EdgarMata/MY-Laser-CNC/278374579_10227413343910427_8267274377528883599_n.jpg

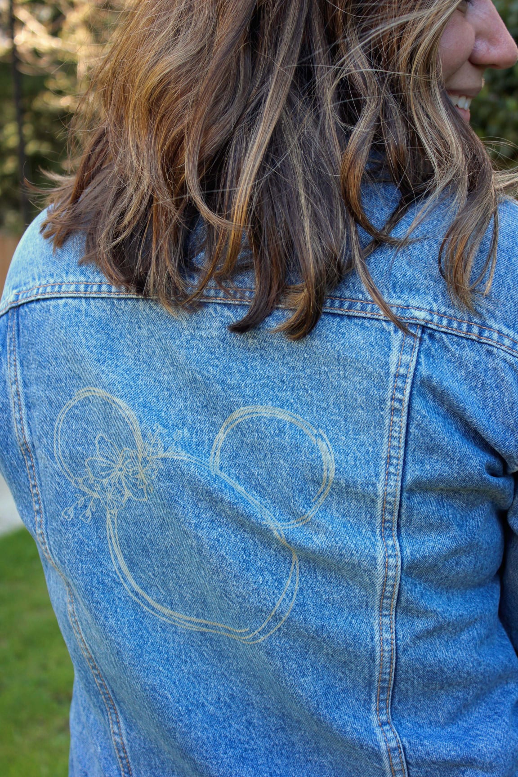
278374579_10227413343910427_8267274377528883599_n.jpg
