EdgarMata/MY-Laser-CNC/278366584_10227413344310437_1615012592259334442_n.jpg

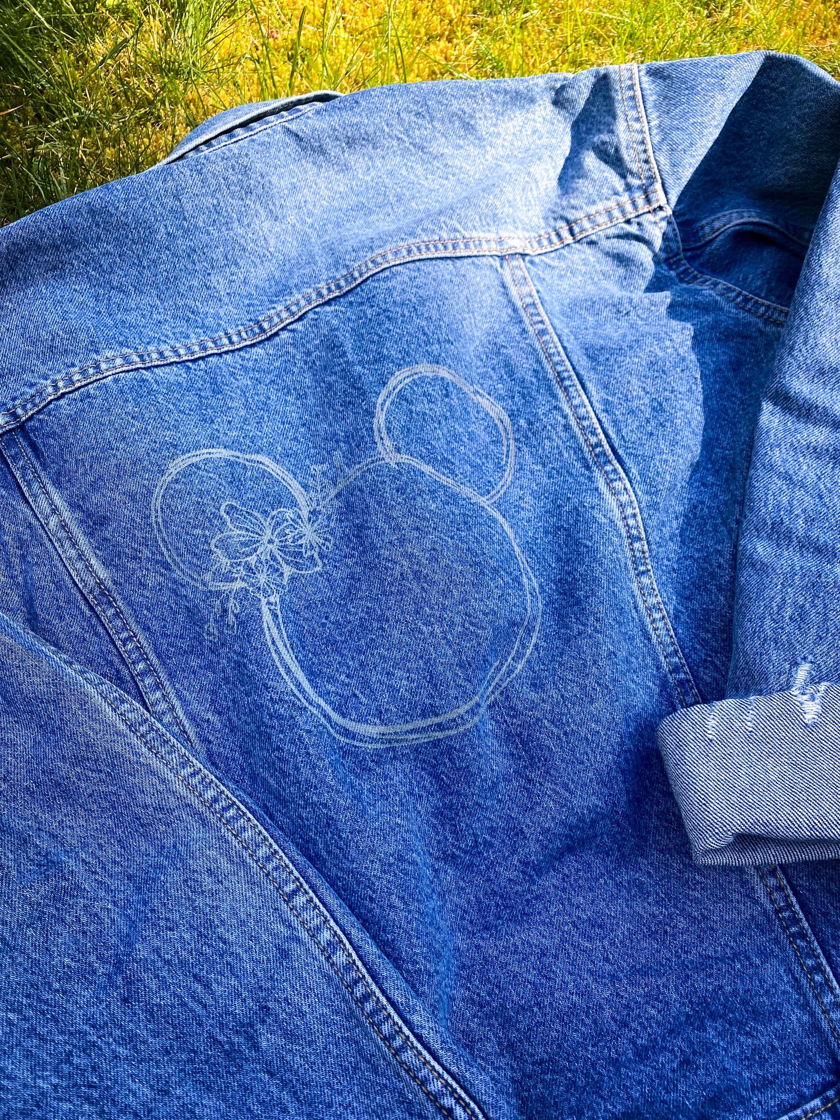
278366584_10227413344310437_1615012592259334442_n.jpg
