EdgarMata/MY-Laser-CNC/Ai Assist 12V - Ortur LaserMaster 2/README.txt

Ortur Lasermaster 2, Air-Assist 12V by PLAY3Rone977 on Thingiverse: https://www.thingiverse.com/thing:4603611
