EdgarMata/MY-Laser-CNC/Dragchain mounts - Ortur LaserMaster 2/README.txt

Ortur laser master 2 dragchain mounts by Jaytjuh575 on Thingiverse: https://www.thingiverse.com/thing:4782844
