EdgarMata/MY-Laser-CNC/Height Adjustment - Ortur LaserMaster 2/README.txt

Height Adjustment Ortur Laser Master 2, Höhenverstellung Lasermaster 2 by PLAY3Rone977 on Thingiverse: https://www.thingiverse.com/thing:4607685
