EdgarMata/MY-Laser-CNC/86872527-235a1d80-c10f-11ea-974b-6ad1a2480c95.png

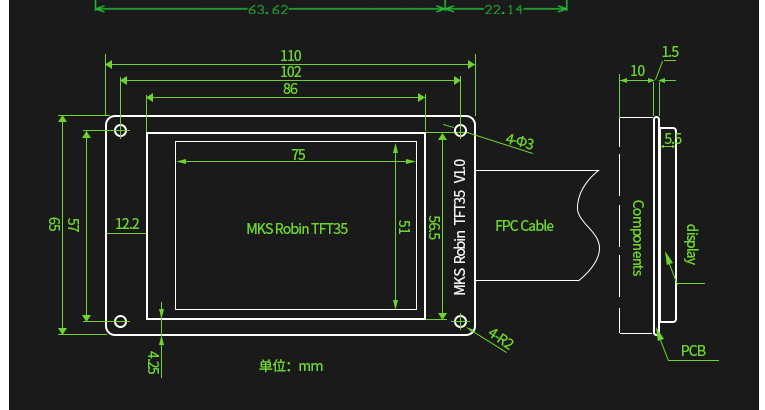
86872527-235a1d80-c10f-11ea-974b-6ad1a2480c95.png
