EdgarMata/MY-Laser-CNC/278289350_10227413347870526_7224577717583131568_n.jpg

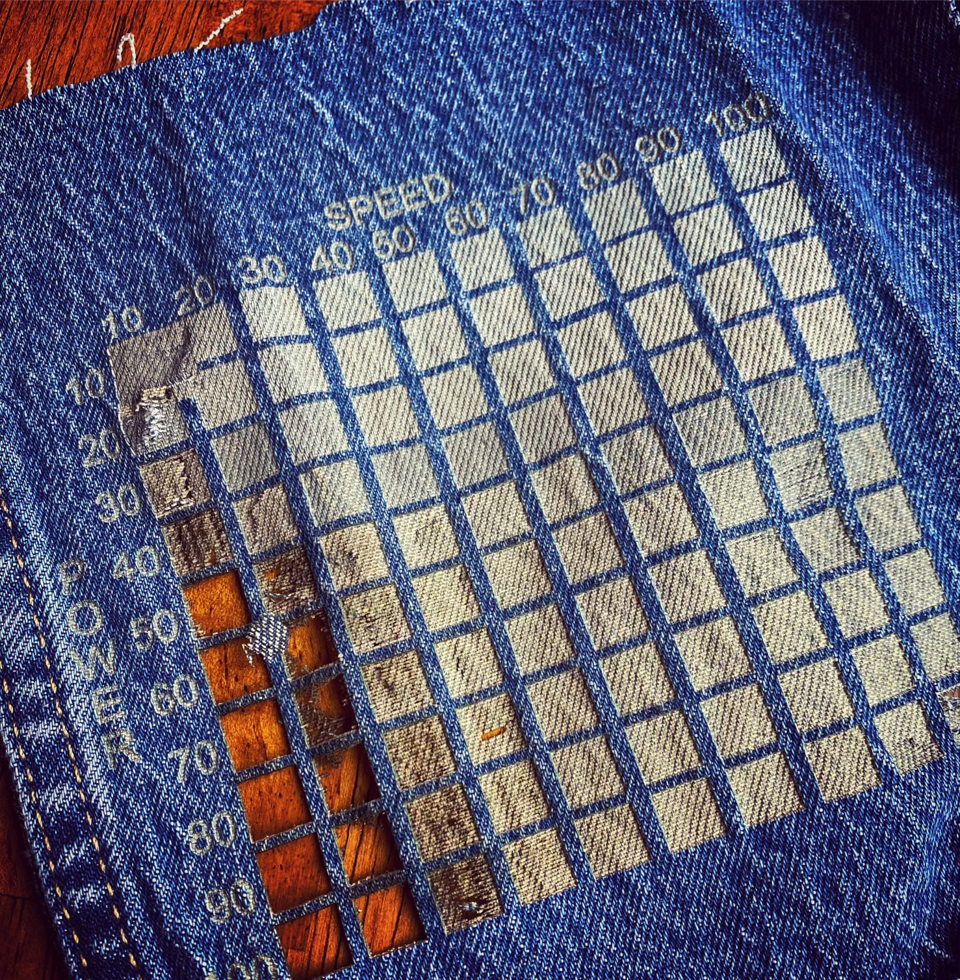
278289350_10227413347870526_7224577717583131568_n.jpg
