EdgarMata/MY-Laser-CNC/1862522707-1764711335.jpg

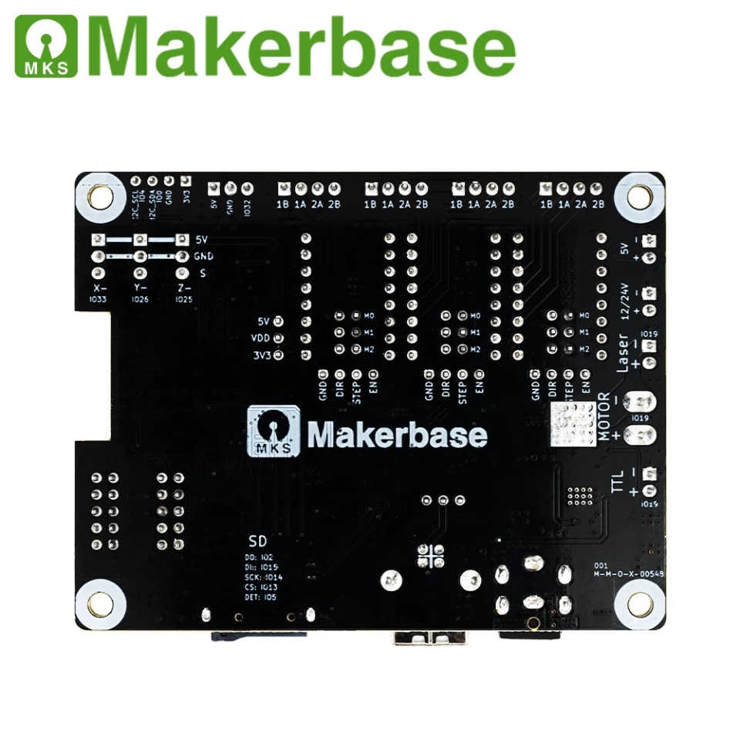
1862522707-1764711335.jpg
