EdgarMata/MY-Laser-CNC/1863638398-807966274.jpg

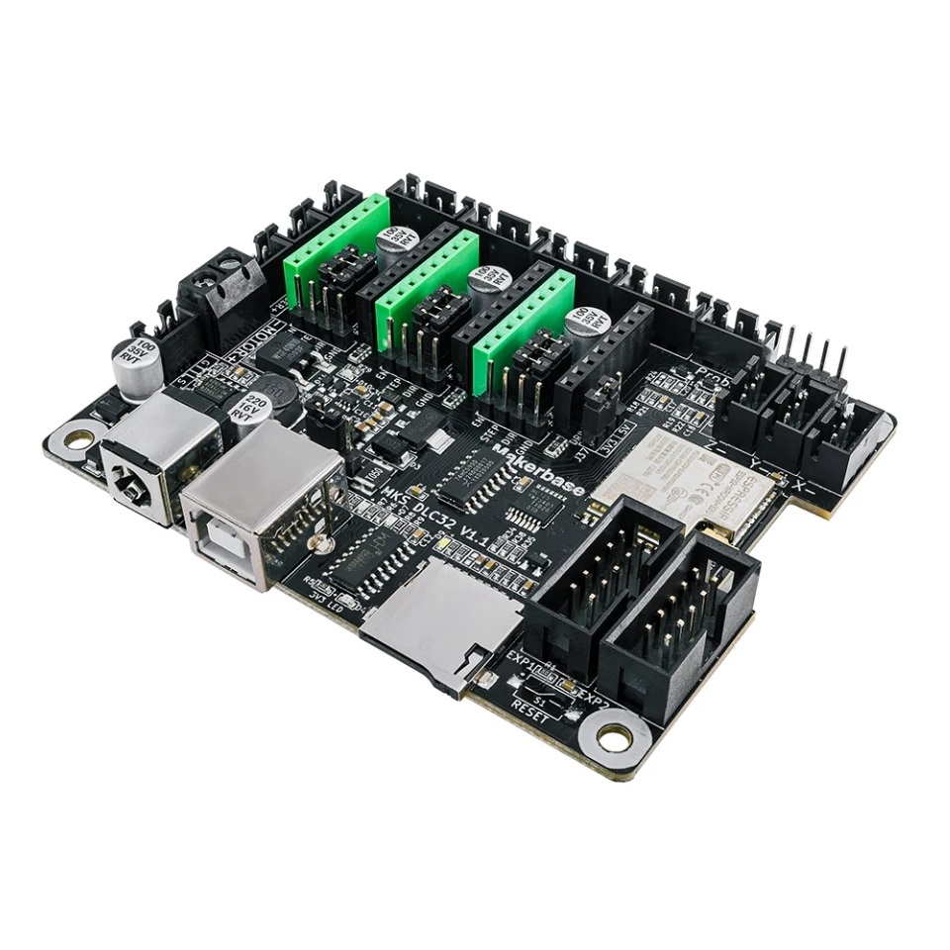
1863638398-807966274.jpg
