EdgarMata/MY-Laser-CNC/10772418951689463713.jpg

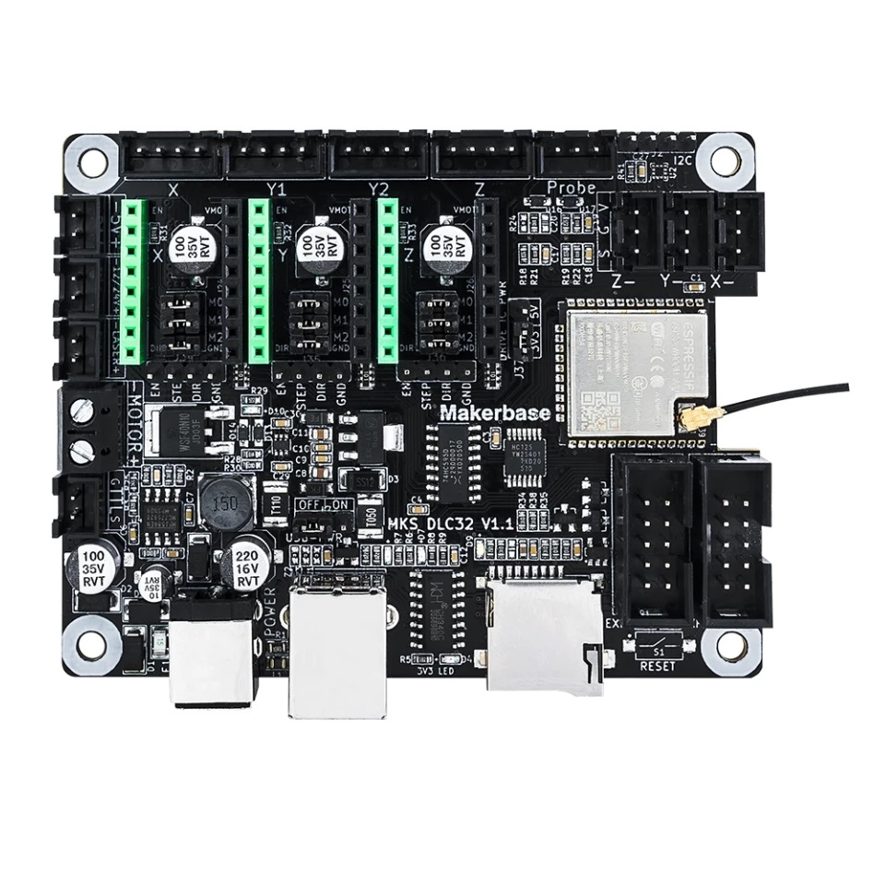
10772418951689463713.jpg
