EdgarMata/MY-Laser-CNC/140004821104248758.jpg

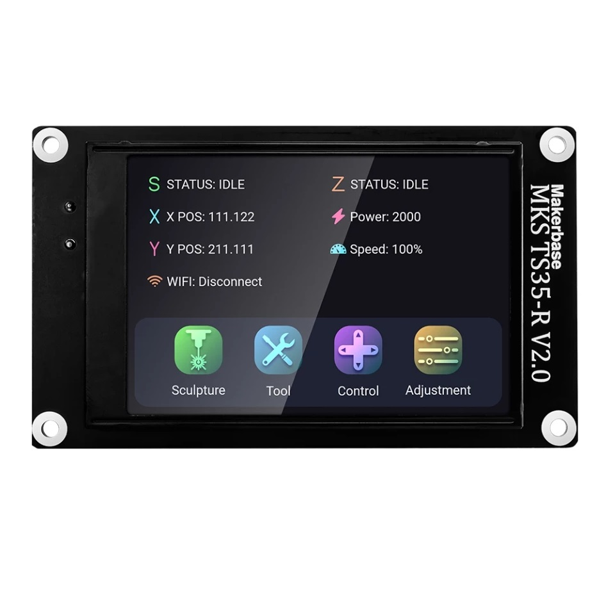
140004821104248758.jpg
