EdgarMata/MY-Laser-CNC/-18785047531269914618.jpg

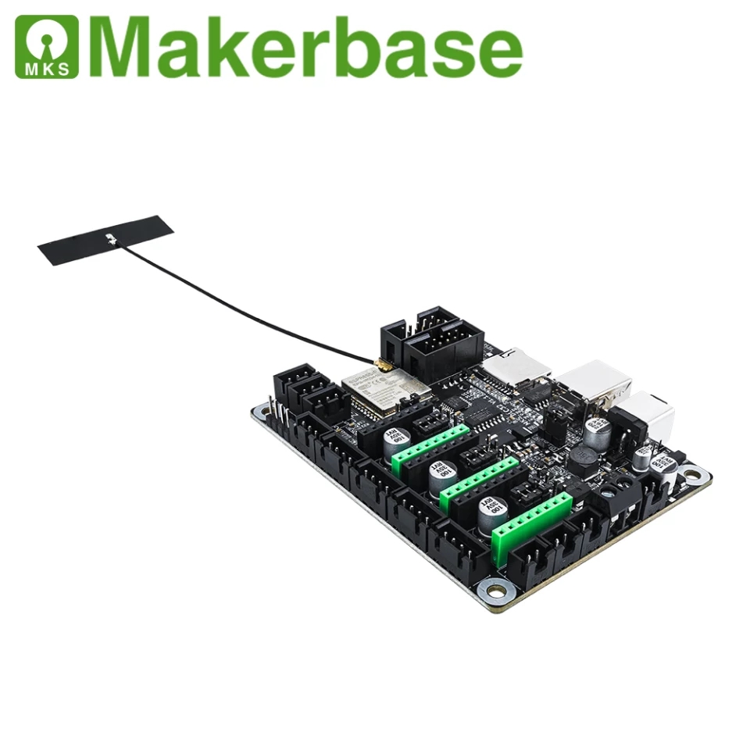
-18785047531269914618.jpg
