EdgarMata/MY-Laser-CNC/Dragchain mounts - Ortur LaserMaster 2/images/LM2_dragchain.jpg

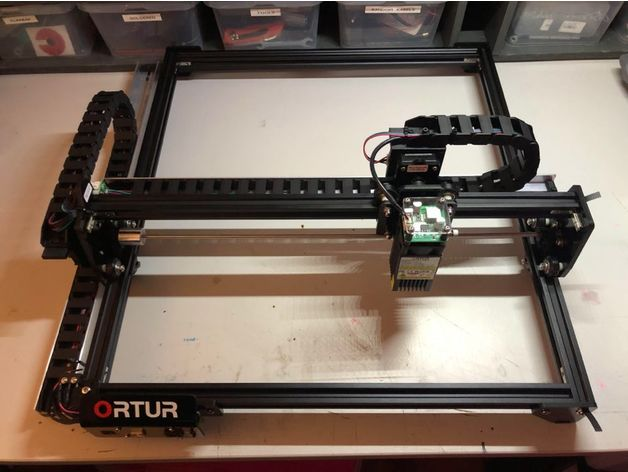
Dragchain mounts - Ortur LaserMaster 2/images/LM2_dragchain.jpg
