EdgarMata/MY-Laser-CNC/Folder.jpg

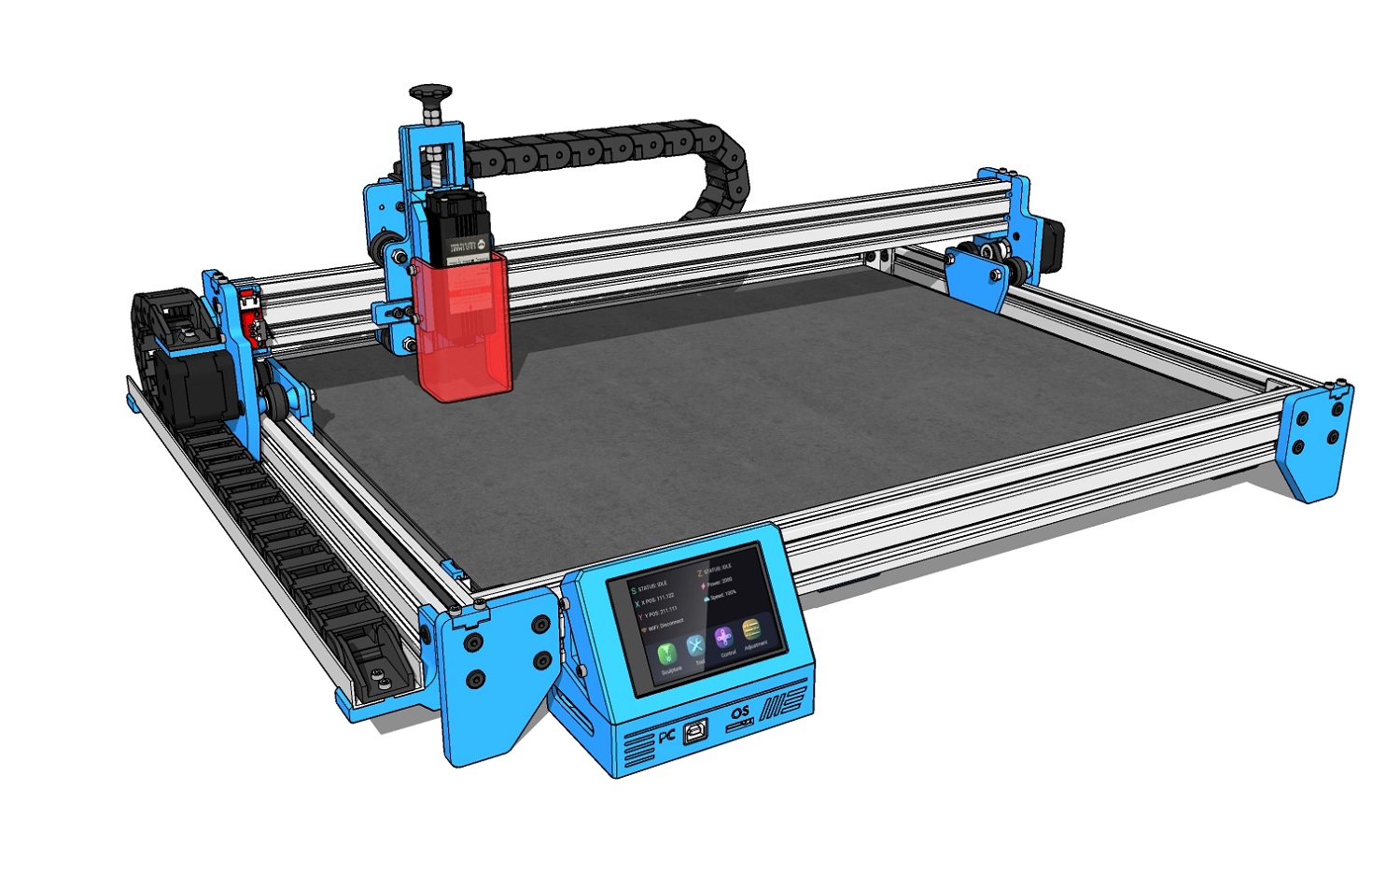
Folder.jpg
