EdgarMata/MY-Laser-CNC/H888757e903234decbe2551f1c8249cb4Z.webp

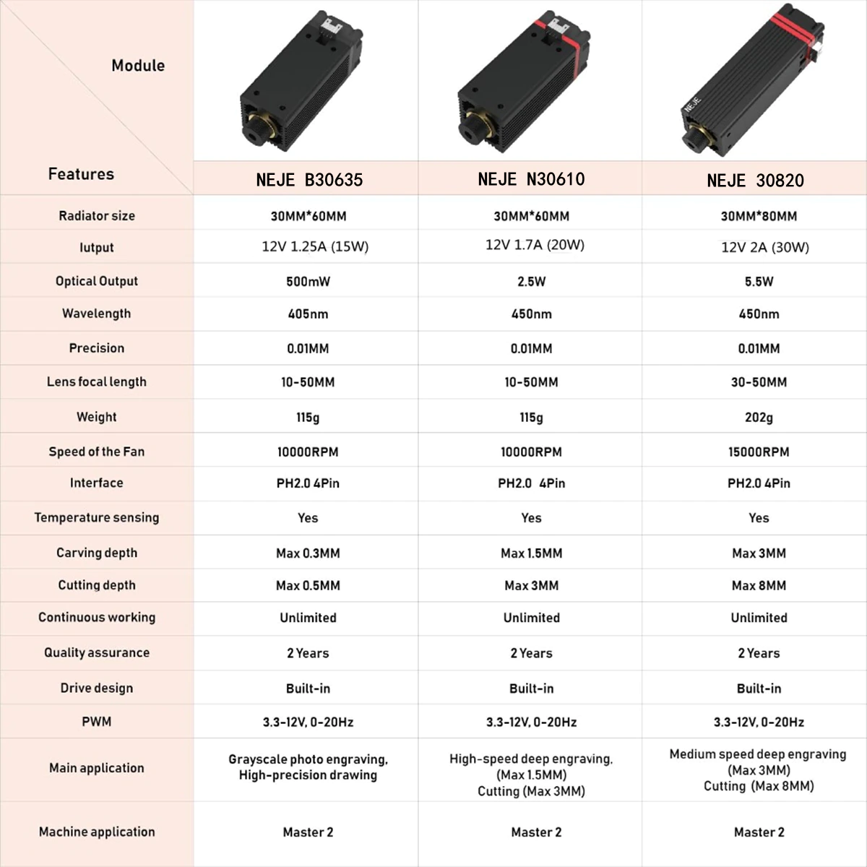
H888757e903234decbe2551f1c8249cb4Z.webp
