EdgarMata/MY-Laser-CNC/Hef795750736949a4b8c11edd0c90db7ev.webp

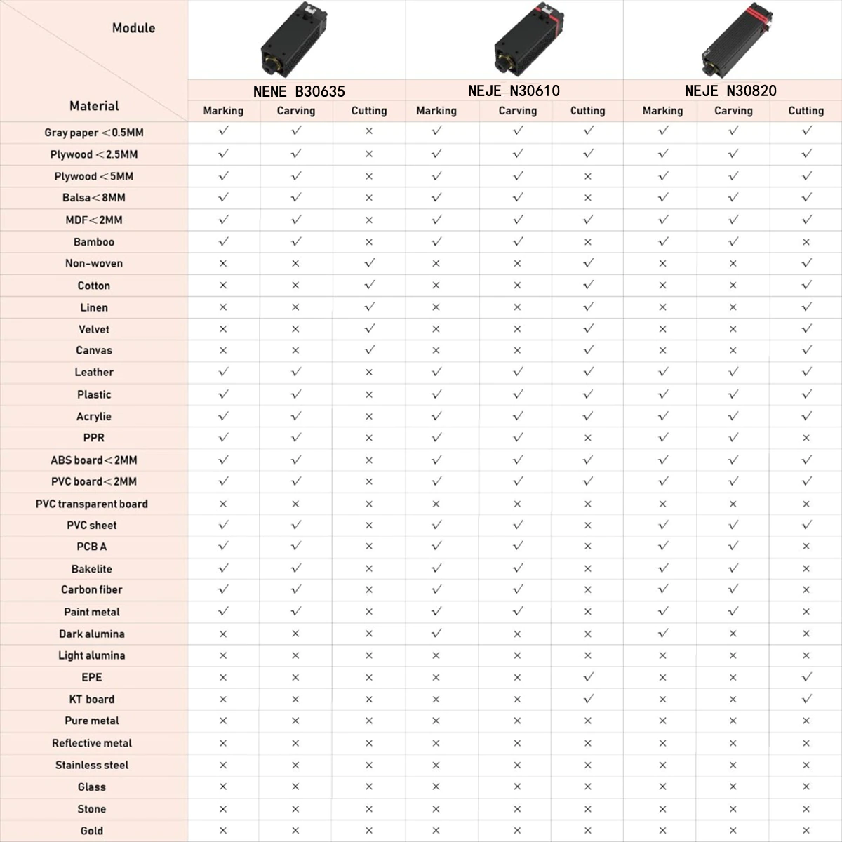
Hef795750736949a4b8c11edd0c90db7ev.webp
