EdgarMata/MY-Laser-CNC/IMG_20220122_154536_4.jpg

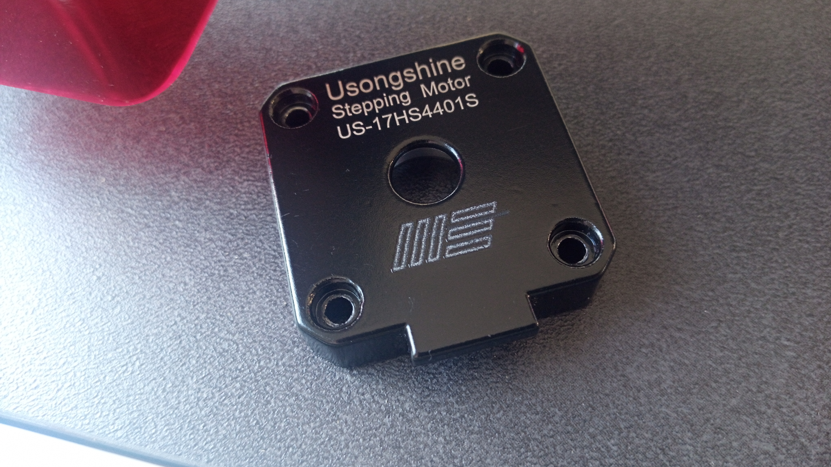
IMG_20220122_154536_4.jpg
