EdgarMata/MY-Laser-CNC/IMG_20220824_092456_1.jpg

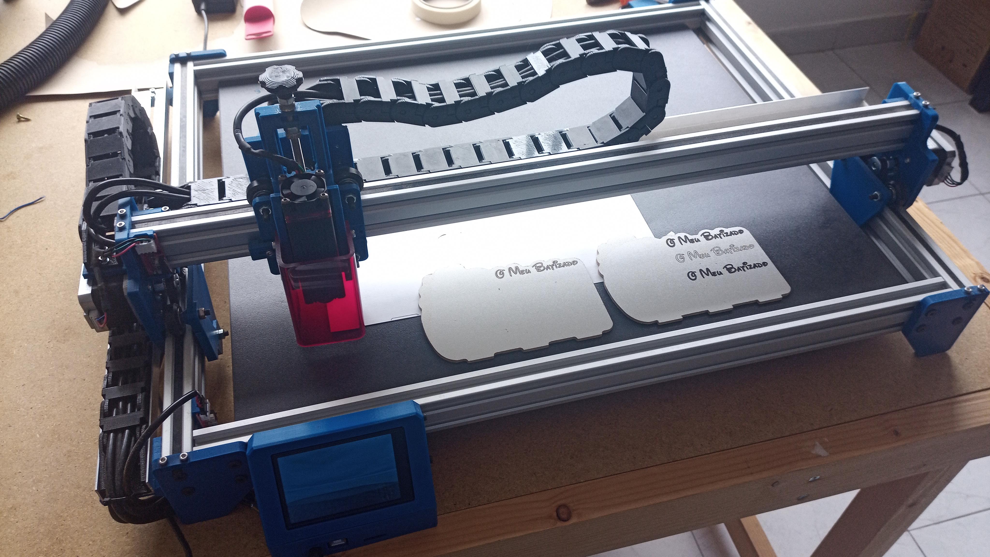
IMG_20220824_092456_1.jpg
