EdgarMata/MY-Laser-CNC/IMG_20220824_092500_9.jpg

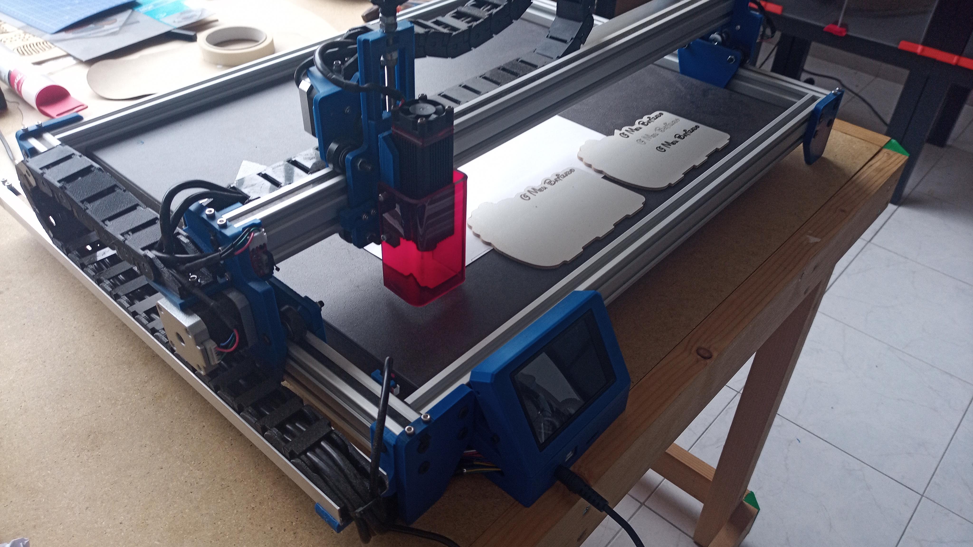
IMG_20220824_092500_9.jpg
