EdgarMata/MY-Laser-CNC/IMG_20220824_092505_9.jpg

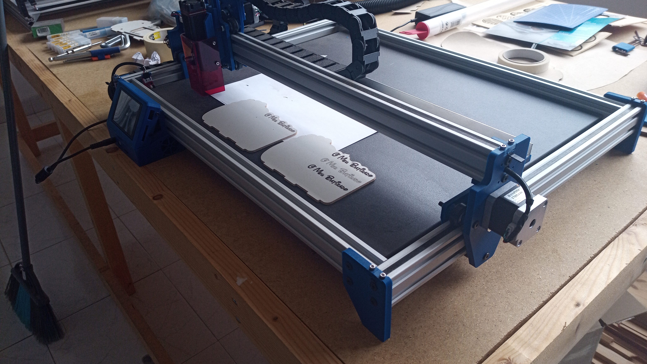
IMG_20220824_092505_9.jpg
