EdgarMata/MY-Laser-CNC/ME - Laser CNC V2_01 - Cópia.jpg

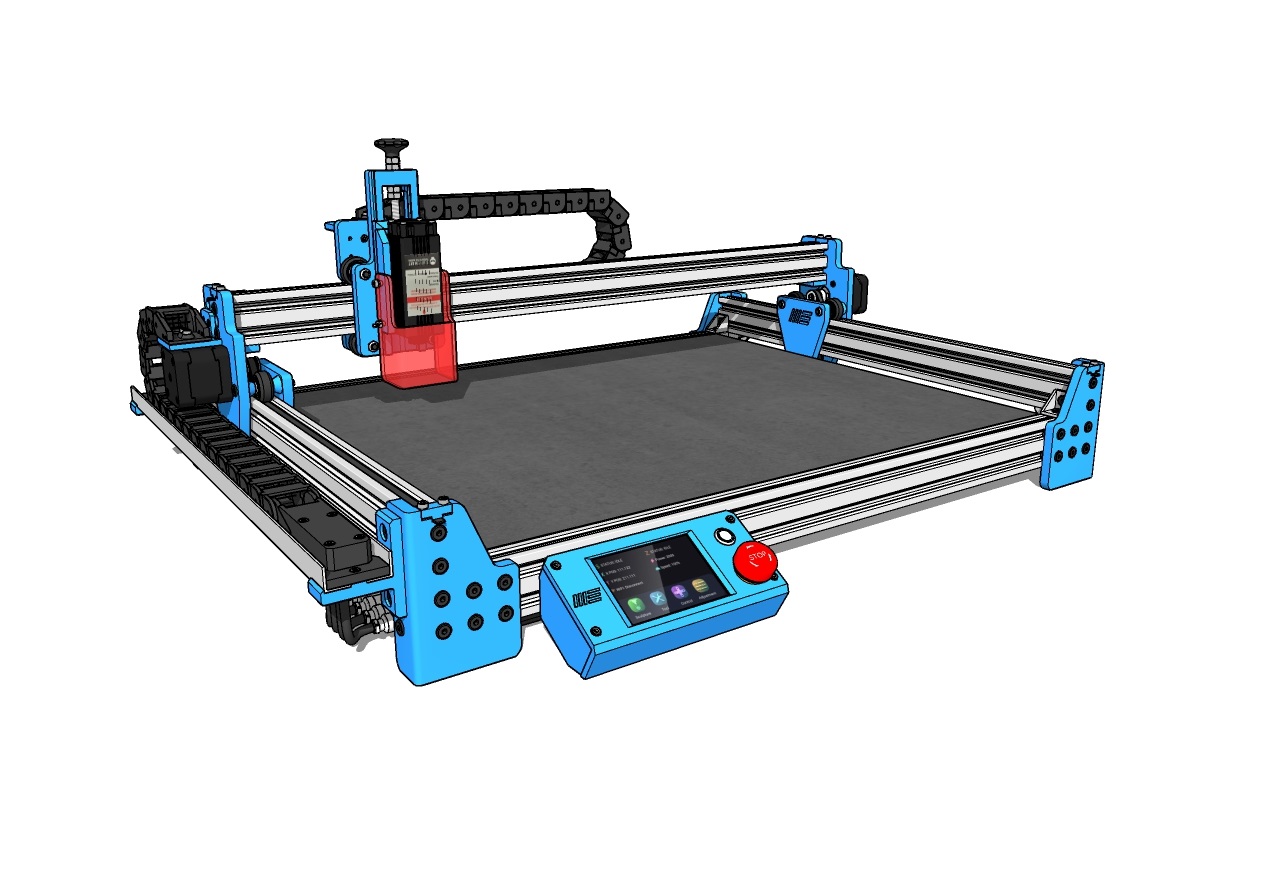
ME - Laser CNC V2_01 - Cópia.jpg
