EdgarMata/MY-Laser-CNC/ME - Laser CNC V2_01.jpg

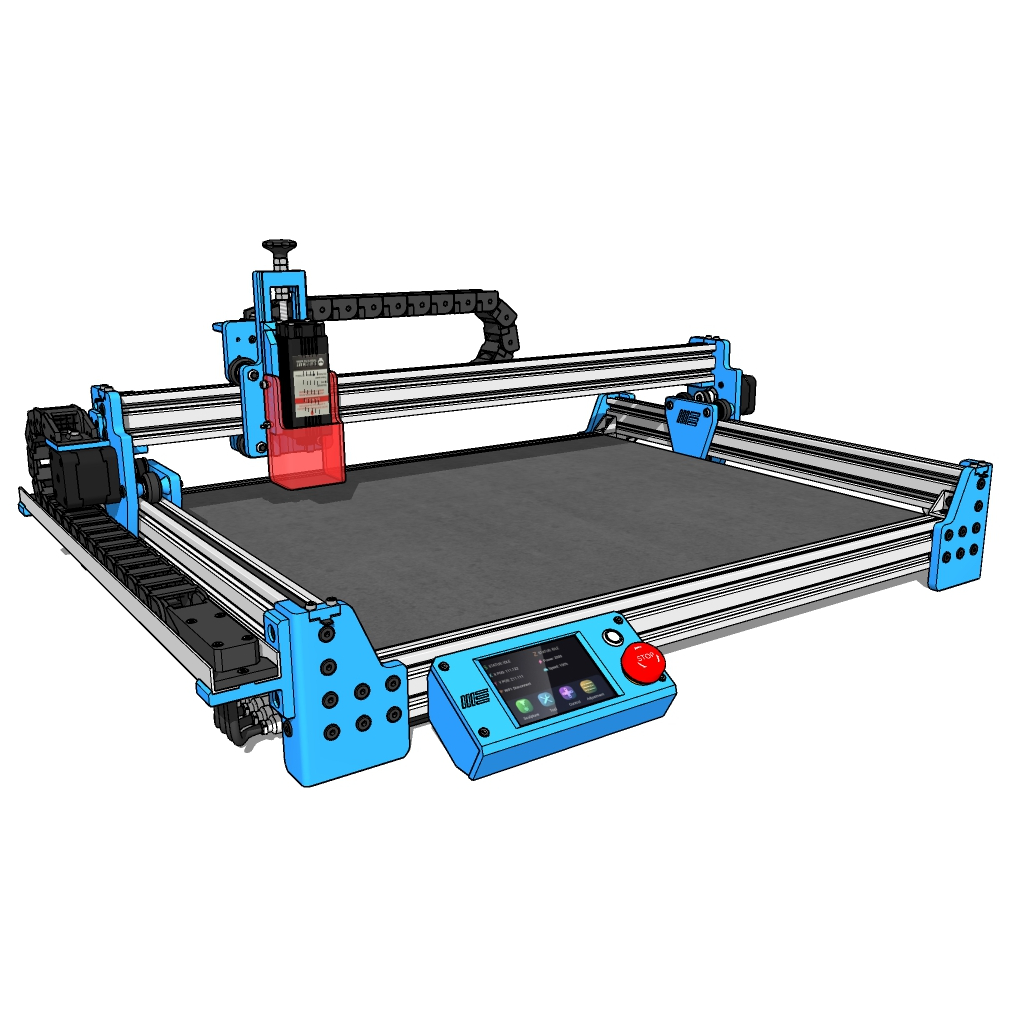
ME - Laser CNC V2_01.jpg
