EdgarMata/MY-Laser-CNC/ME - Laser CNC V2_02.jpg

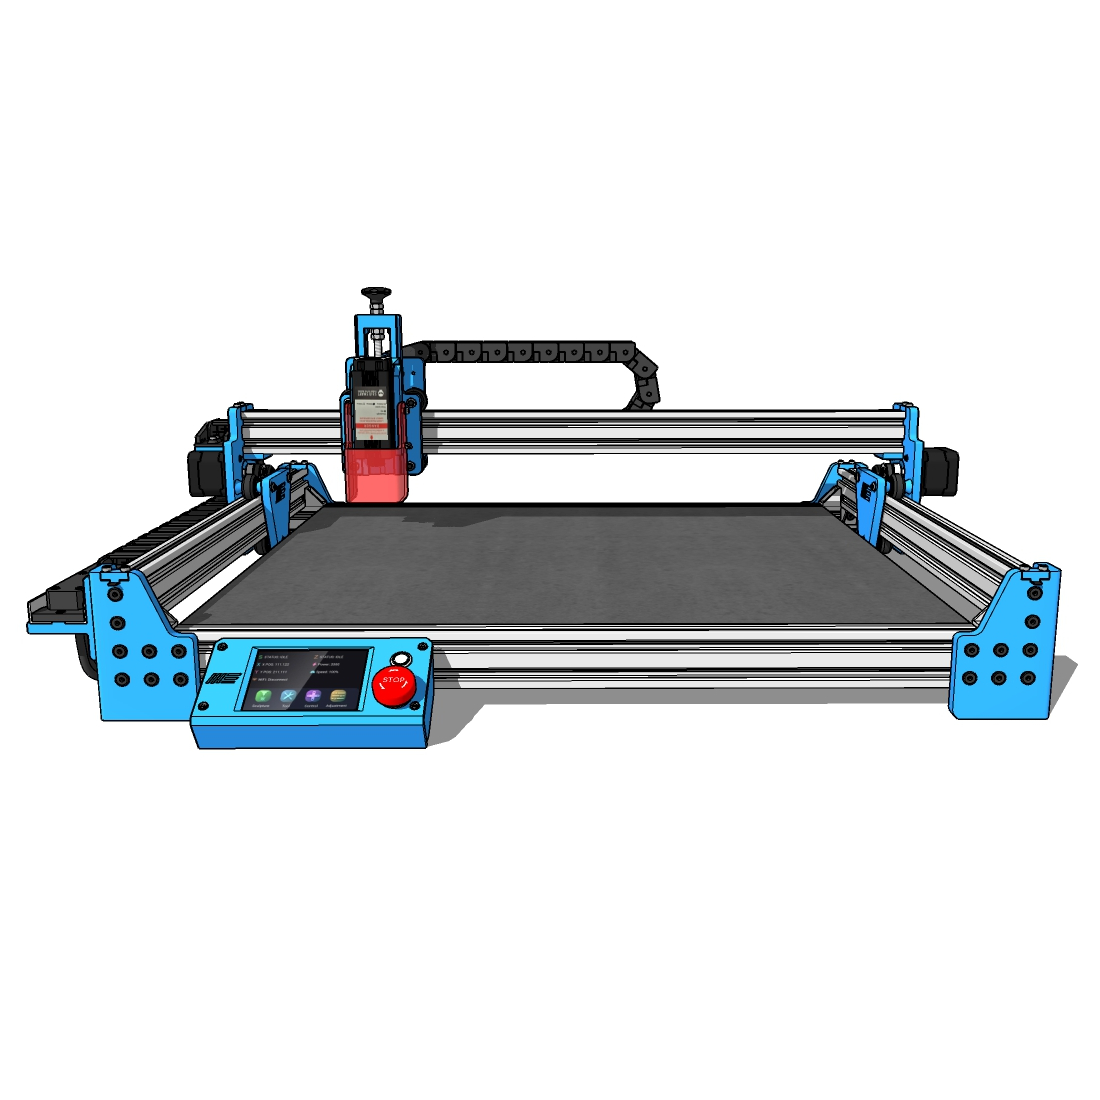
ME - Laser CNC V2_02.jpg
