EdgarMata/MY-Laser-CNC/ME - Laser CNC V2_03.jpg

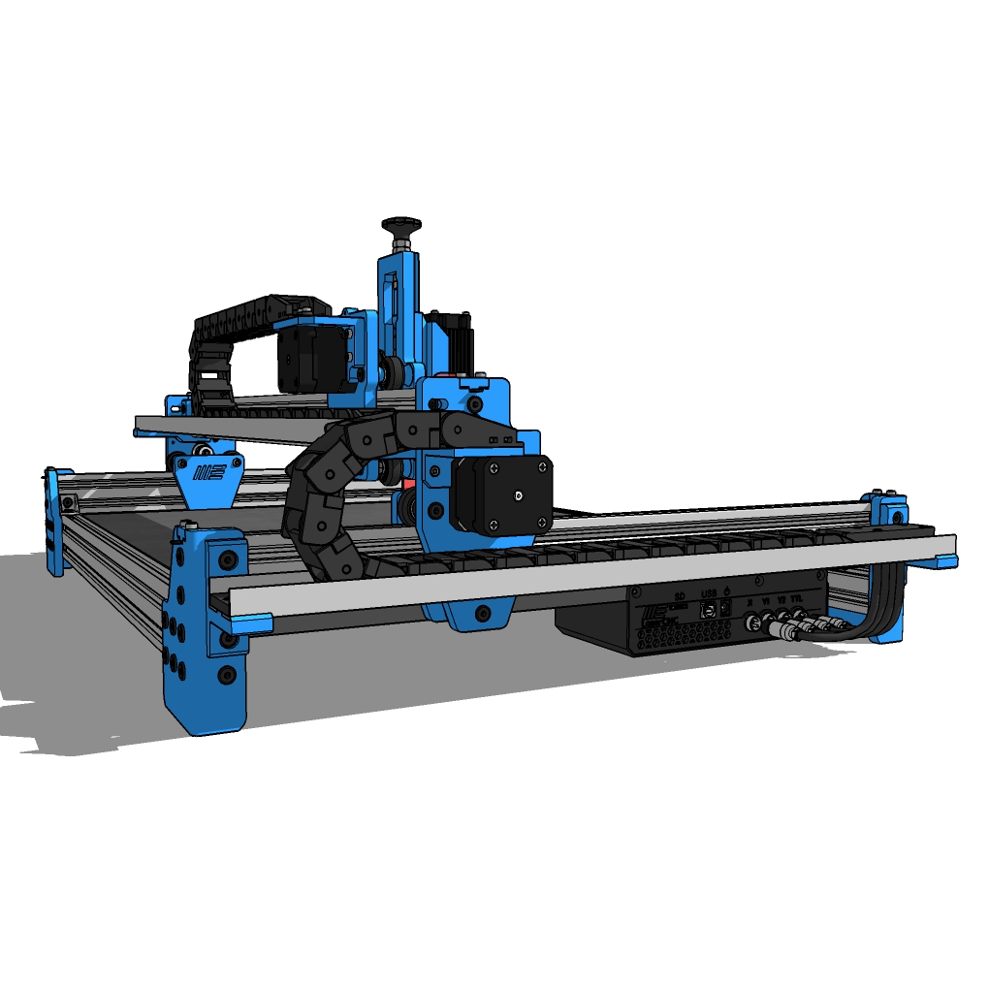
ME - Laser CNC V2_03.jpg
