EdgarMata/MY-Laser-CNC/ME - Laser CNC V2_04.jpg

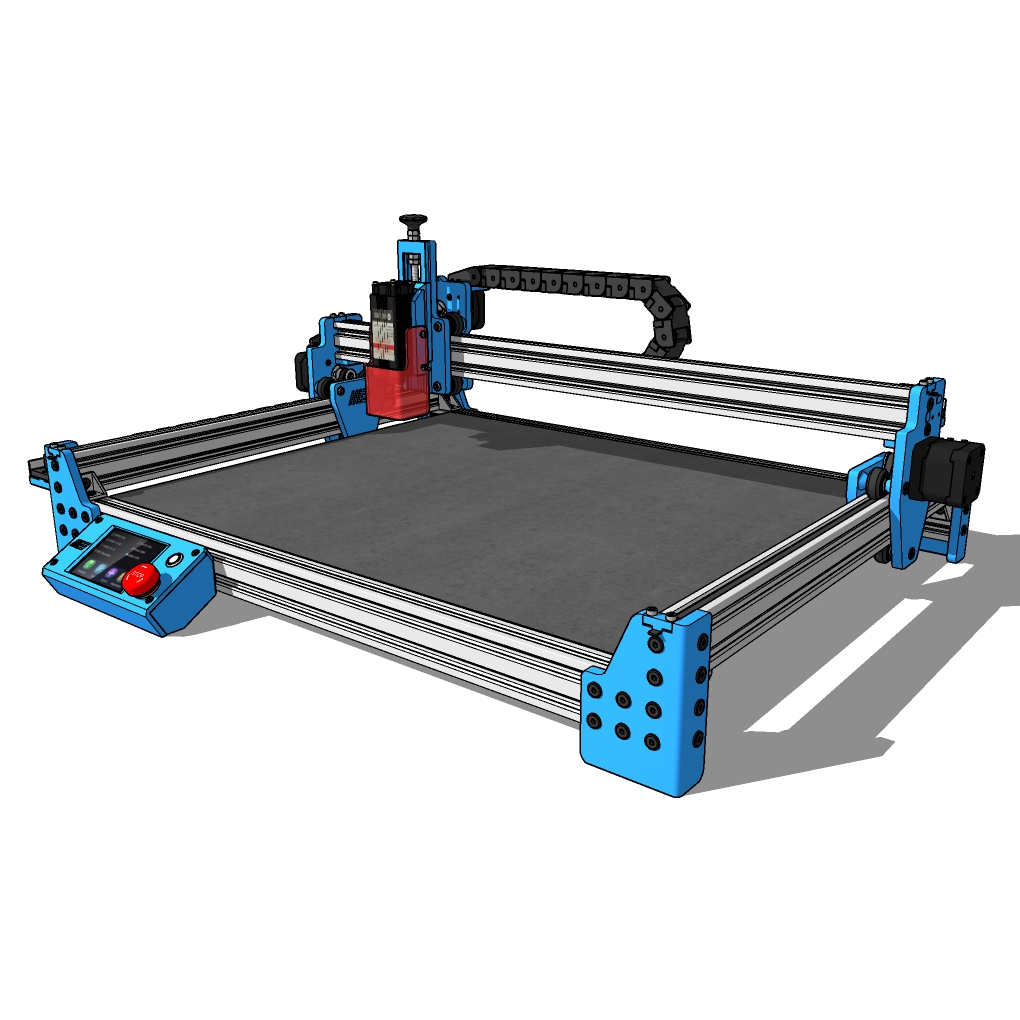
ME - Laser CNC V2_04.jpg
