EdgarMata/MY-Laser-CNC/ME - Laser CNC V2_05.jpg

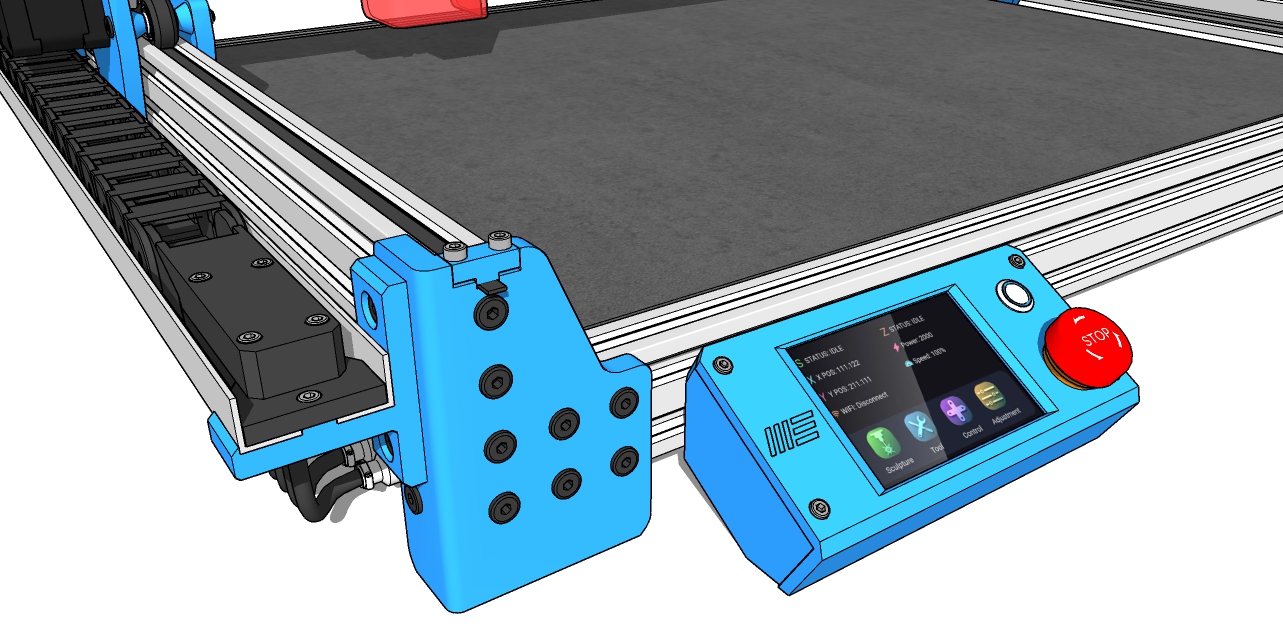
ME - Laser CNC V2_05.jpg
