EdgarMata/MY-Laser-CNC/ME - Laser CNC V2_06.jpg

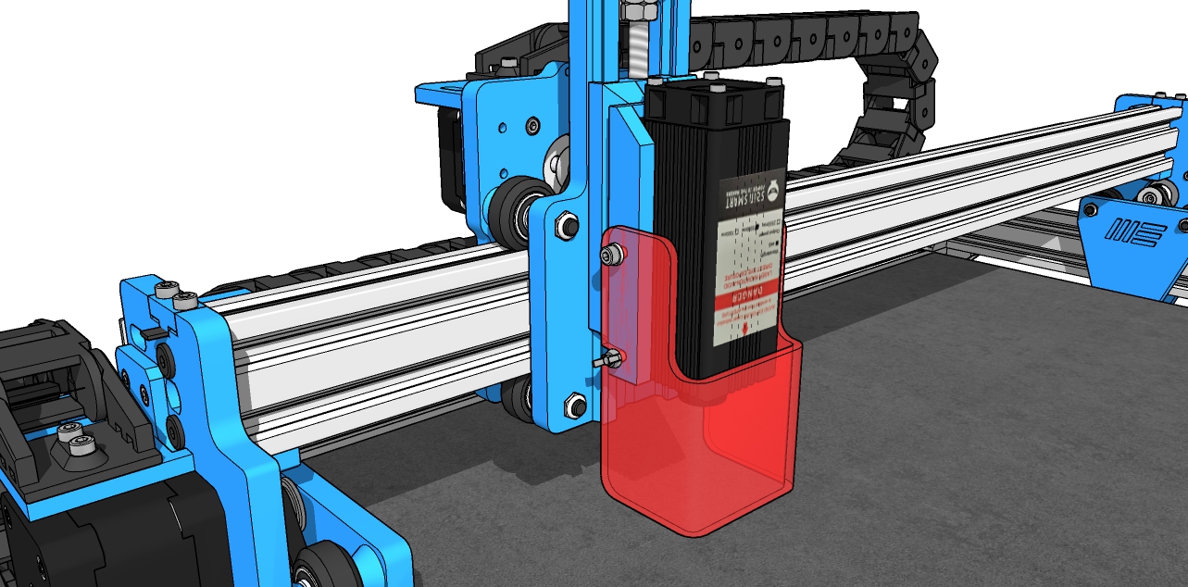
ME - Laser CNC V2_06.jpg
