EdgarMata/MY-Laser-CNC/ME - Laser CNC V2_08.jpg

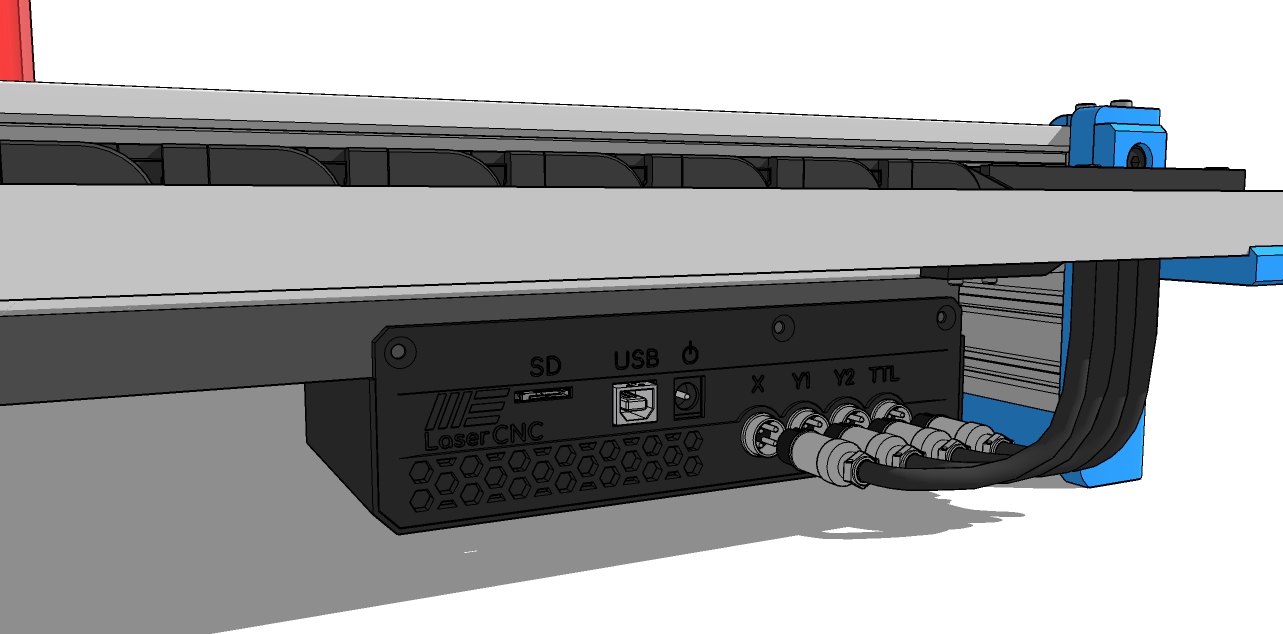
ME - Laser CNC V2_08.jpg
