EdgarMata/MY-Laser-CNC/ME - Laser CNC V2_09.jpg

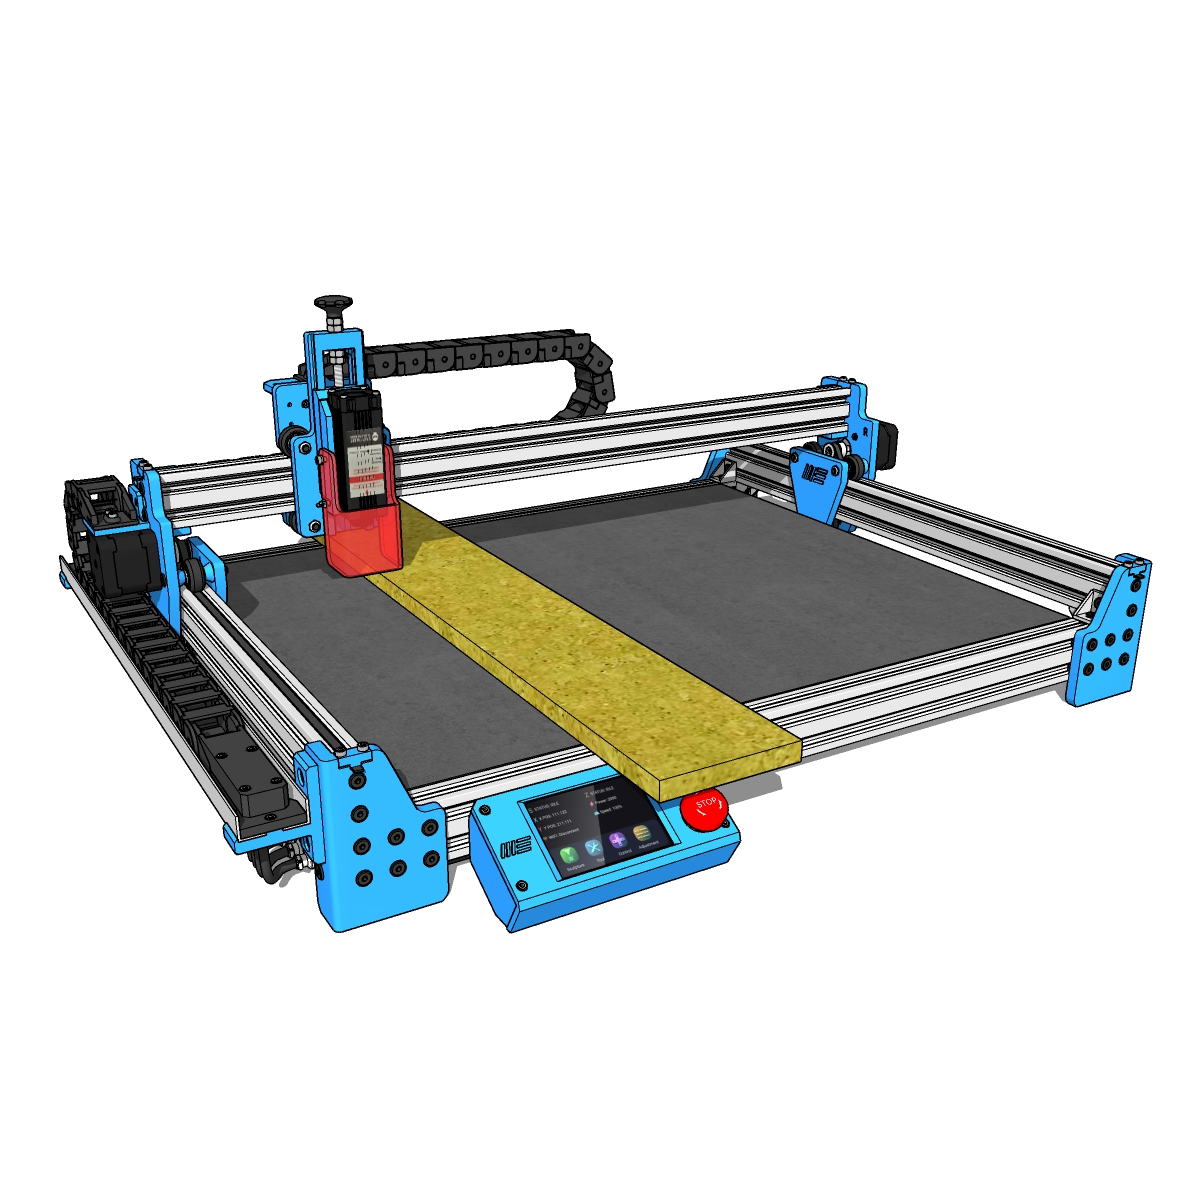
ME - Laser CNC V2_09.jpg
