EdgarMata/MY-Laser-CNC/tela-lcd-12864-controlador-grafico-inteligente-completo.jpg

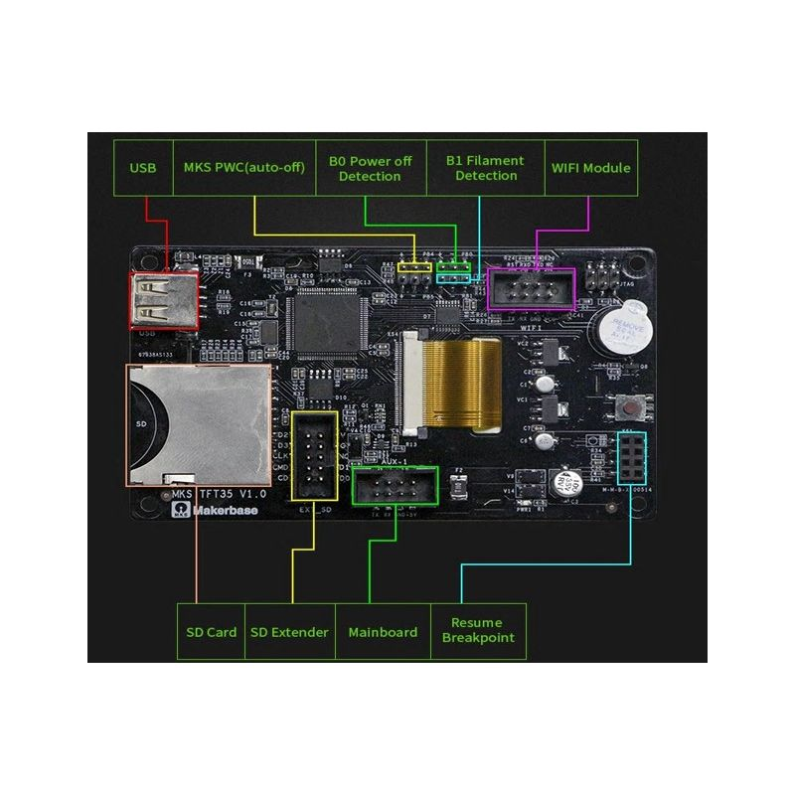
tela-lcd-12864-controlador-grafico-inteligente-completo.jpg
