EdgarMata/MY-Laser-CNC/Videos/ME-Laser CNC Timelaps.png

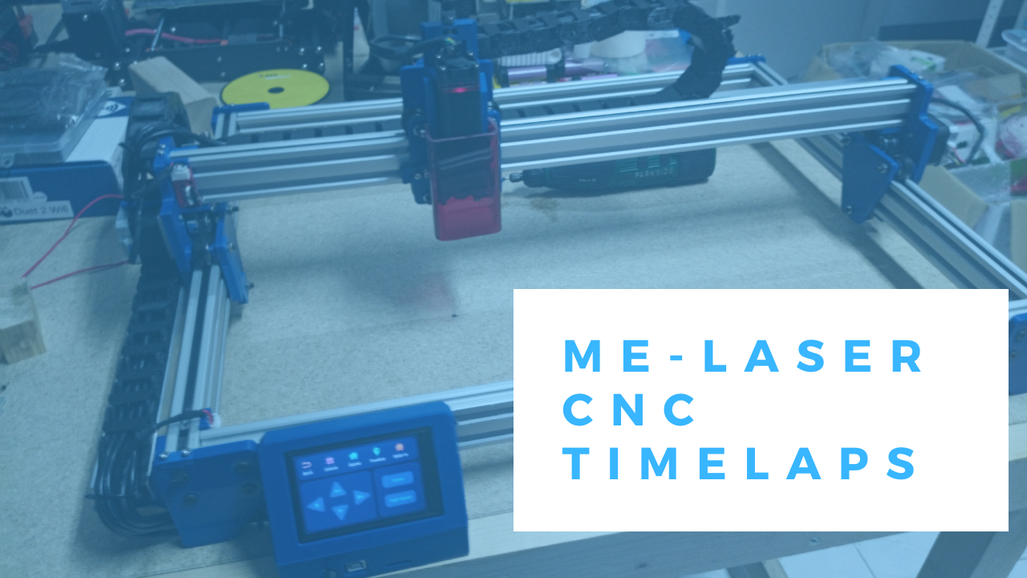
Videos/ME-Laser CNC Timelaps.png
