EdgarMata/MY-Laser-CNC/STL/Belt Holder.stl

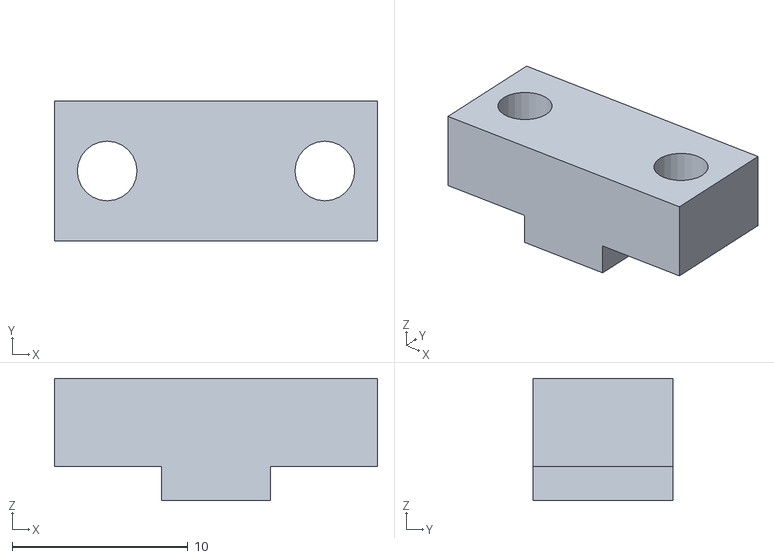
[picture p29: CAD file, 2025-06-22]
STL/Belt Holder.stl
18.4 x 8.00 x 6.95
