EdgarMata/MY-Laser-CNC/STL/X Gantry Outer Mount Plate.stl

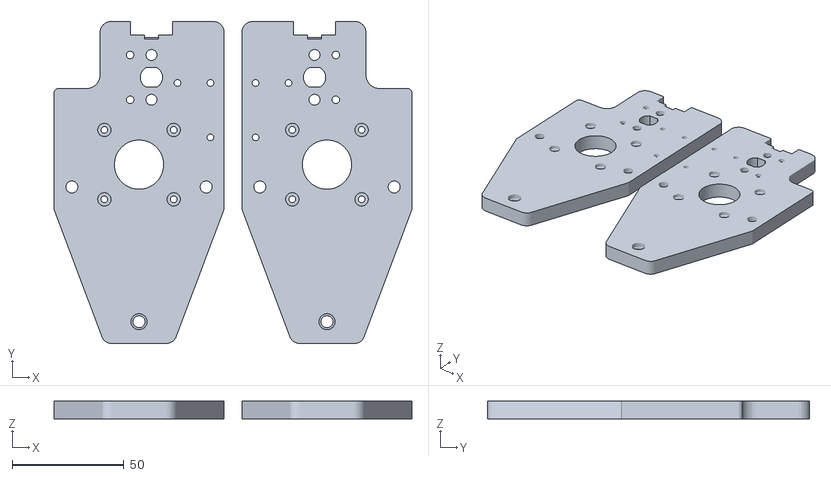
[picture p30: CAD file, 2025-06-22]
STL/X Gantry Outer Mount Plate.stl
160.0 x 144.0 x 8.00
