EdgarMata/MY-Laser-CNC/STL/Chain Link.stl

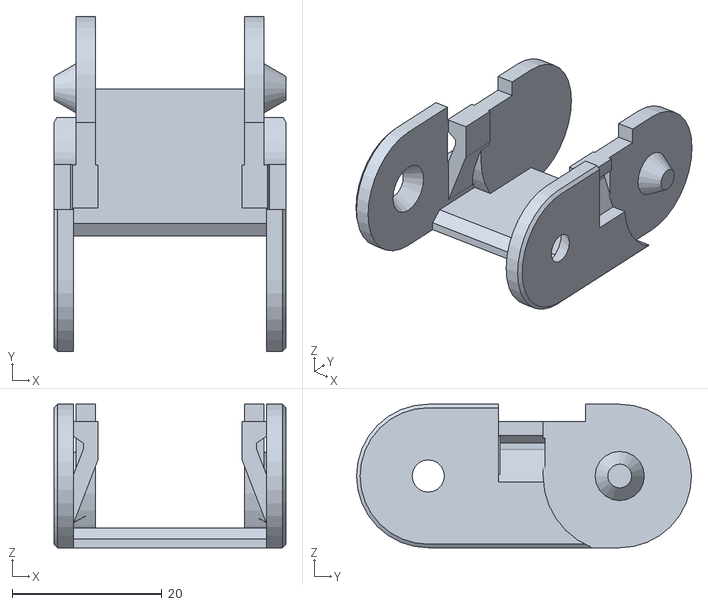
[picture p31: CAD file, 2025-06-22]
STL/Chain Link.stl
31.0 x 44.8 x 19.2
