EdgarMata/MY-Laser-CNC/STL/Laser beam eye protection holder.stl

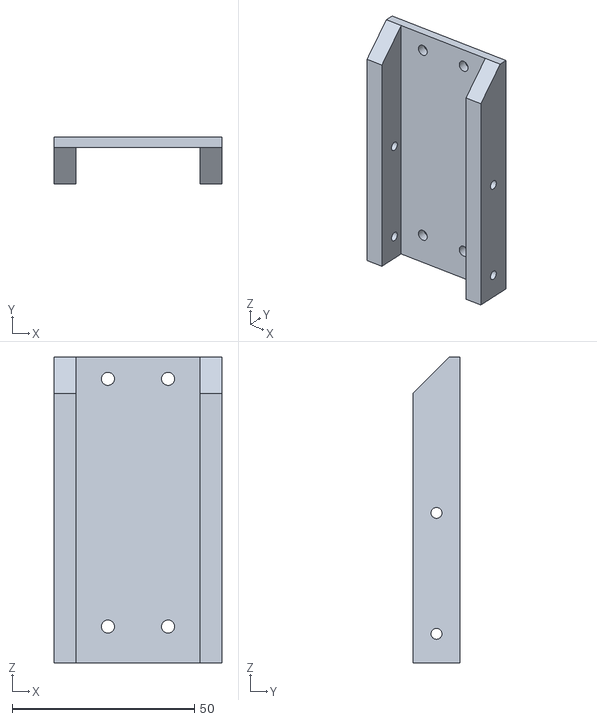
[picture p32: CAD file, 2025-06-22]
STL/Laser beam eye protection holder.stl
46.0 x 13.0 x 84.0
