EdgarMata/MY-Laser-CNC/STL/Chain End Moun.stl

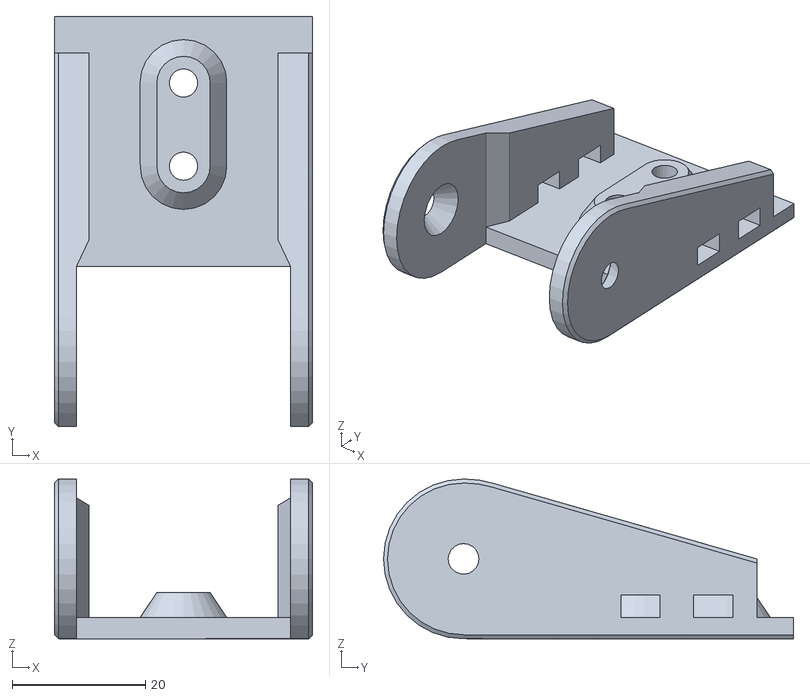
[picture p33: CAD file, 2025-06-22]
STL/Chain End Moun.stl
38.8 x 61.6 x 24.0
