EdgarMata/MY-Laser-CNC/STL/Knob Lower.stl

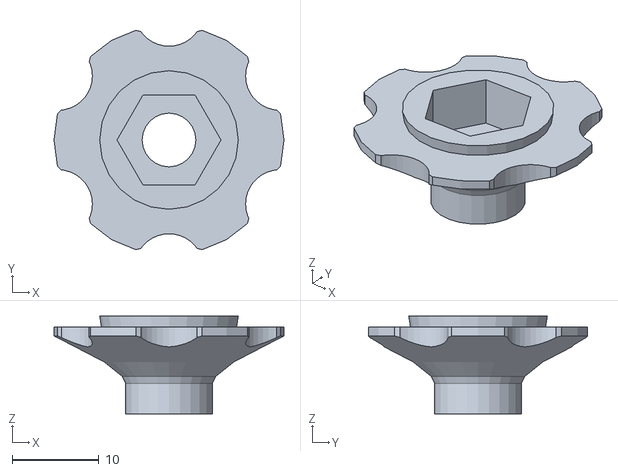
[picture p34: CAD file, 2025-06-22]
STL/Knob Lower.stl
26.5 x 25.3 x 11.3
