EdgarMata/MY-Laser-CNC/STL/Laser Mount Motor Bracket.stl

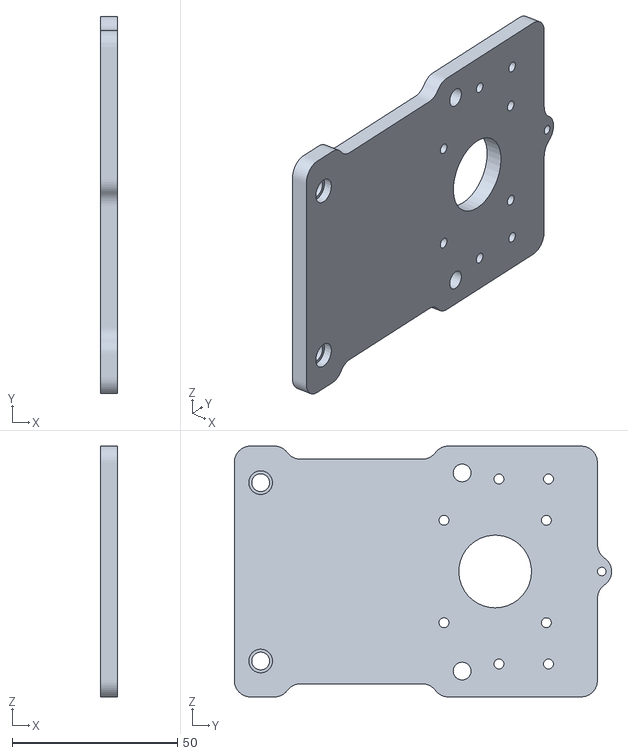
[picture p35: CAD file, 2025-06-22]
STL/Laser Mount Motor Bracket.stl
5.00 x 114.3 x 76.0
