EdgarMata/MY-Laser-CNC/STL/EndStop Suporte.stl

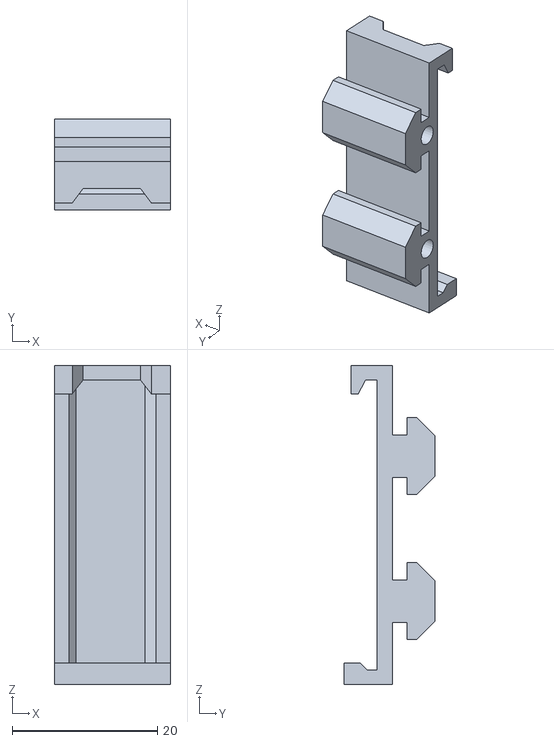
[picture p36: CAD file, 2025-06-22]
STL/EndStop Suporte.stl
16.0 x 12.6 x 44.0
