EdgarMata/MY-Laser-CNC/STL/LCD Support.stl

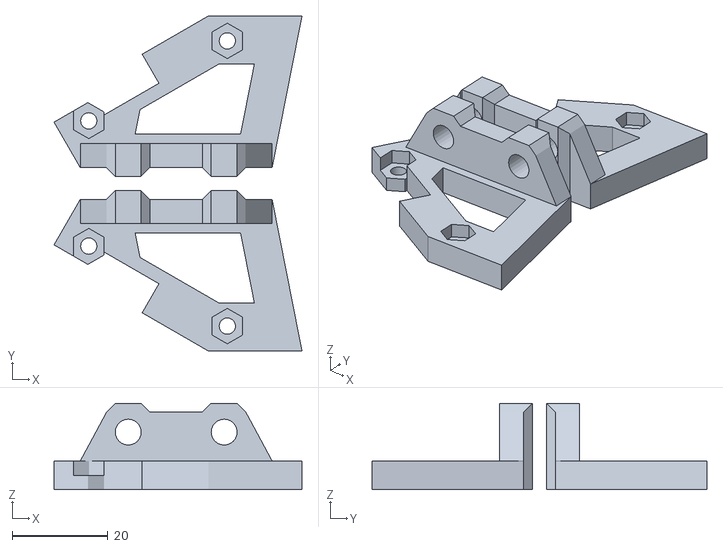
[picture p37: CAD file, 2025-06-22]
STL/LCD Support.stl
51.7 x 69.8 x 18.0
