EdgarMata/MY-Laser-CNC/STL/X EndStop Collider.stl

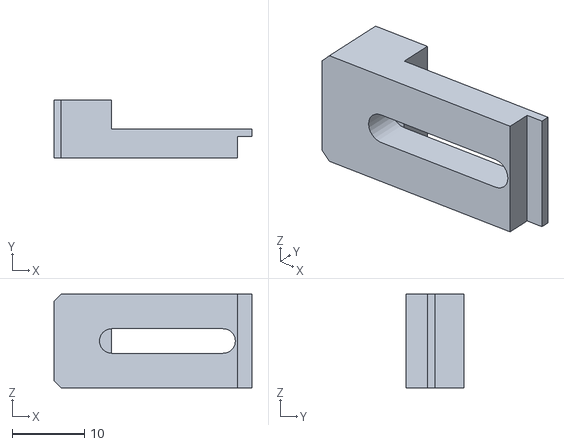
[picture p38: CAD file, 2025-06-22]
STL/X EndStop Collider.stl
27.5 x 8.00 x 13.0
