EdgarMata/MY-Laser-CNC/STL/Chain Link Cover.stl

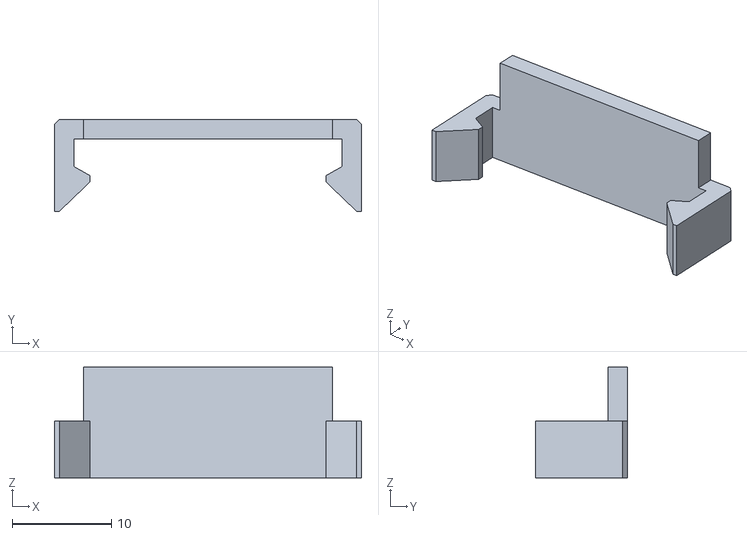
[picture p39: CAD file, 2025-06-22]
STL/Chain Link Cover.stl
31.0 x 9.28 x 11.2
