EdgarMata/MY-Laser-CNC/STL/Base Bracket.stl

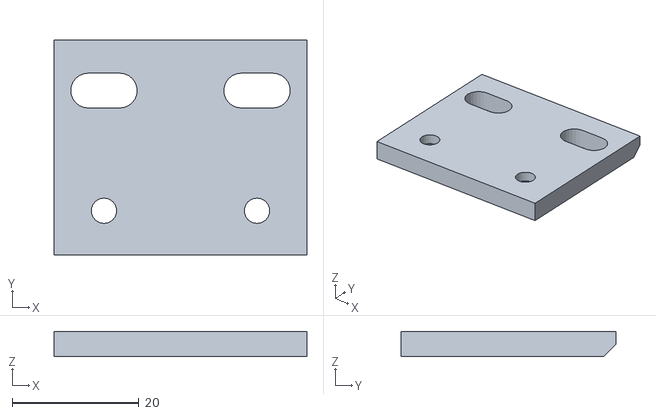
[picture p40: CAD file, 2025-06-22]
STL/Base Bracket.stl
40.0 x 34.0 x 4.00
