EdgarMata/MY-Laser-CNC/STL/Chain Start Moun.stl

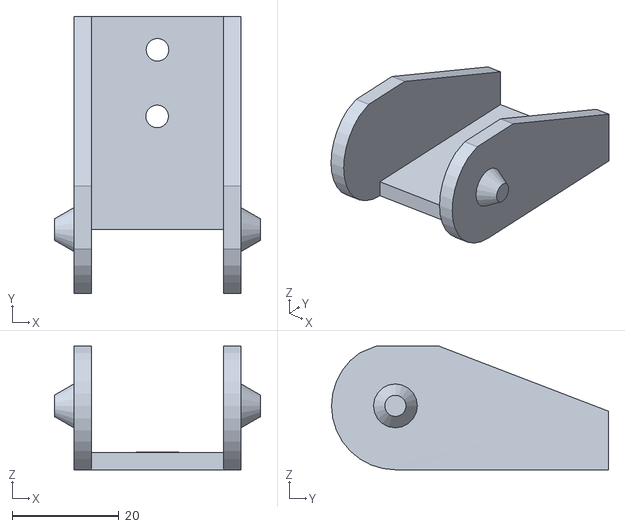
[picture p41: CAD file, 2025-06-22]
STL/Chain Start Moun.stl
38.8 x 52.0 x 23.2
