EdgarMata/MY-Laser-CNC/STL/X Gantry Inner Mount Plate.stl

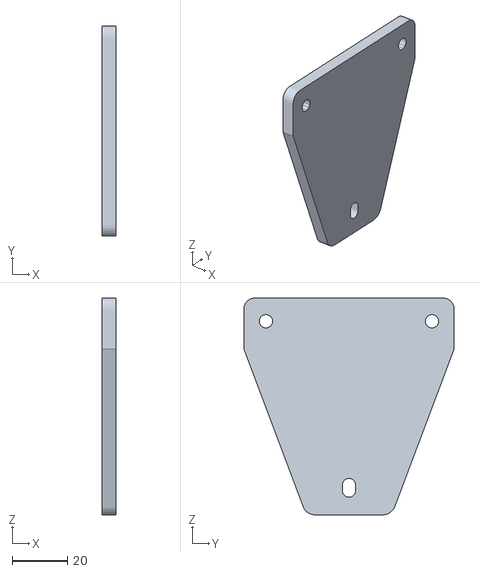
[picture p42: CAD file, 2025-06-22]
STL/X Gantry Inner Mount Plate.stl
5.00 x 76.0 x 78.4
