EdgarMata/MY-Laser-CNC/STL/X Chain Bracket.stl

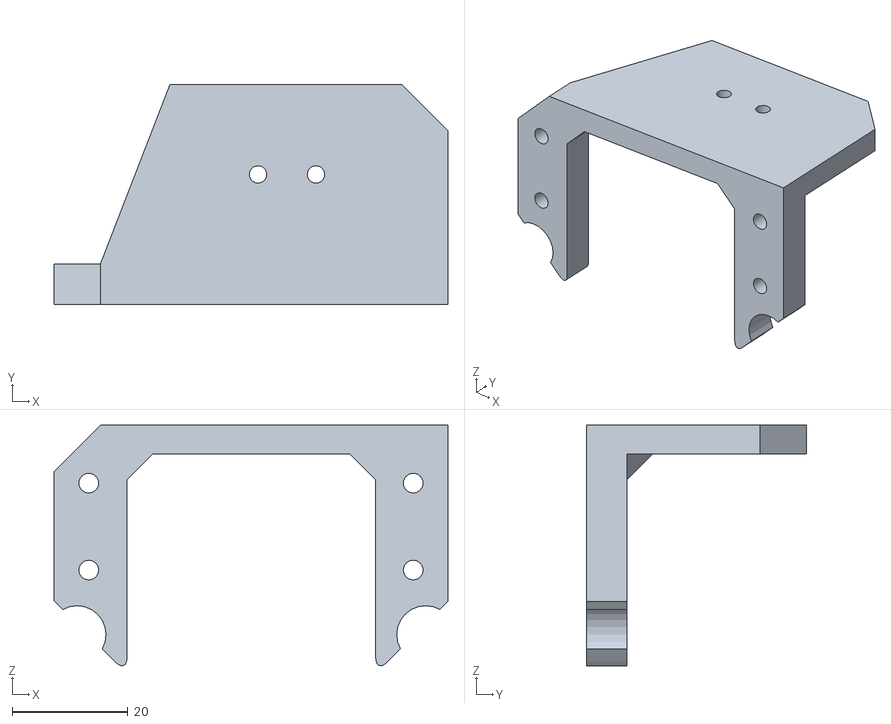
[picture p43: CAD file, 2025-06-22]
STL/X Chain Bracket.stl
68.0 x 38.0 x 41.5
