EdgarMata/MY-Laser-CNC/STL/Dragchain guide mount.stl

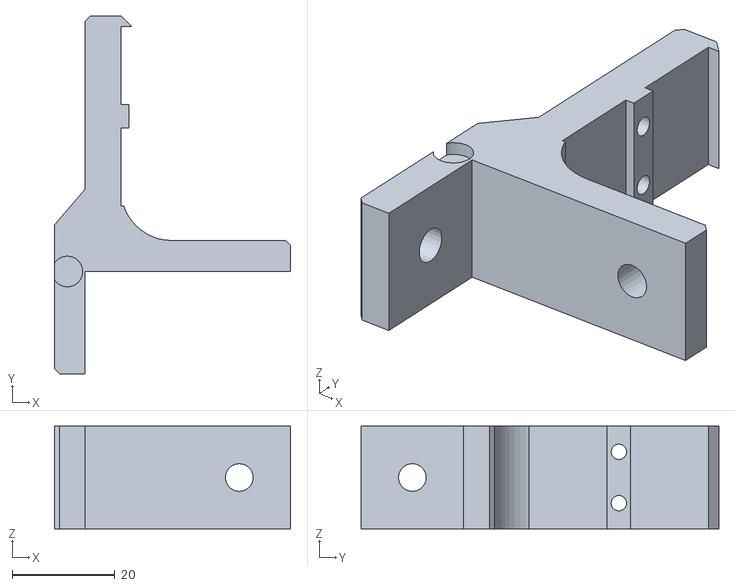
[picture p44: CAD file, 2025-06-22]
STL/Dragchain guide mount.stl
46.0 x 69.7 x 20.0
