EdgarMata/MY-Laser-CNC/STL/L Connector.stl

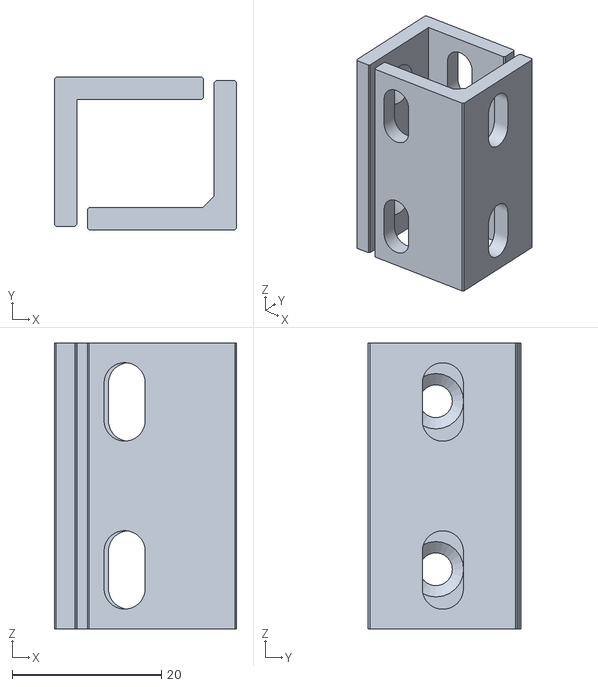
[picture p45: CAD file, 2025-06-22]
STL/L Connector.stl
24.4 x 20.4 x 38.3
