EdgarMata/MY-Laser-CNC/STL/Y EndStop Collider.stl

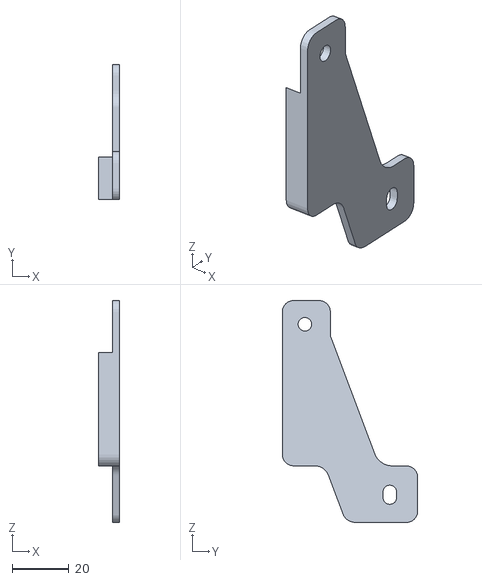
[picture p46: CAD file, 2025-06-22]
STL/Y EndStop Collider.stl
7.50 x 47.8 x 78.4
