EdgarMata/MY-Laser-CNC/STL/Foot.stl

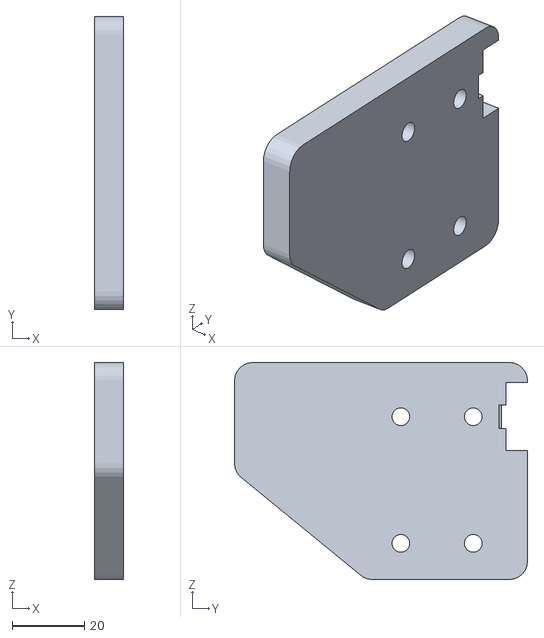
[picture p47: CAD file, 2025-06-22]
STL/Foot.stl
8.00 x 81.0 x 60.0
