EdgarMata/MY-Laser-CNC/STL/Spacer.stl

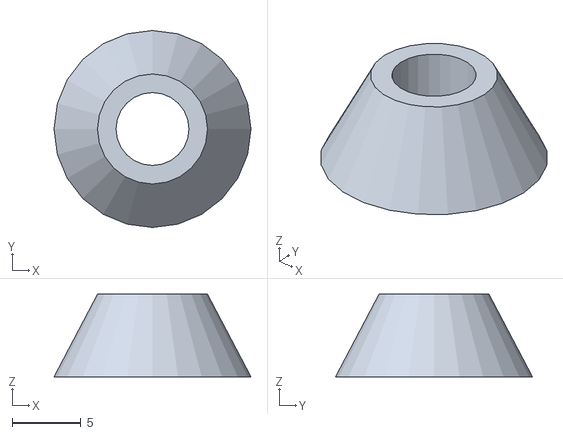
[picture p48: CAD file, 2025-06-22]
STL/Spacer.stl
14.3 x 14.3 x 6.00
