EdgarMata/MY-Laser-CNC/STL/Makerbase Box.stl

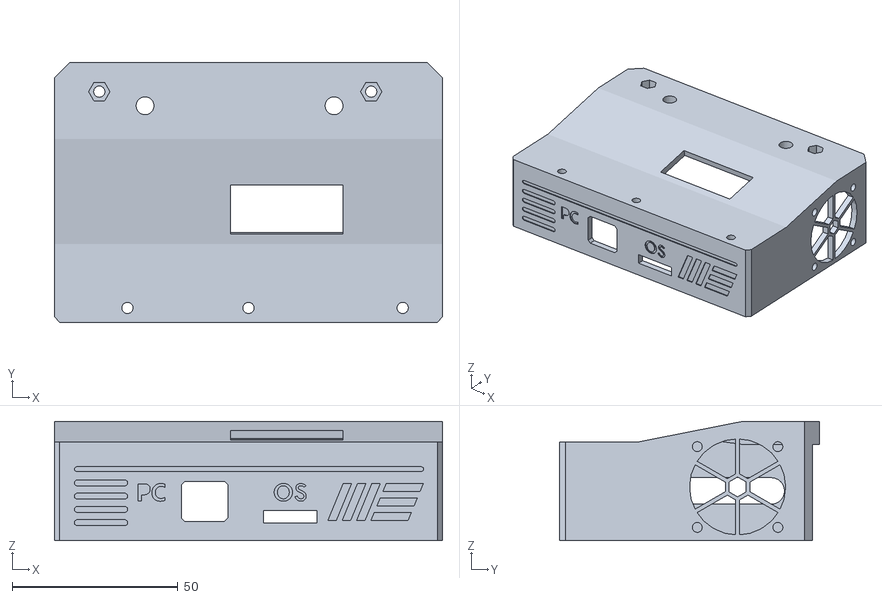
[picture p49: CAD file, 2025-06-22]
STL/Makerbase Box.stl
117.0 x 78.3 x 36.0
