EdgarMata/MY-Laser-CNC/STL/MakerBase Box Cover.stl

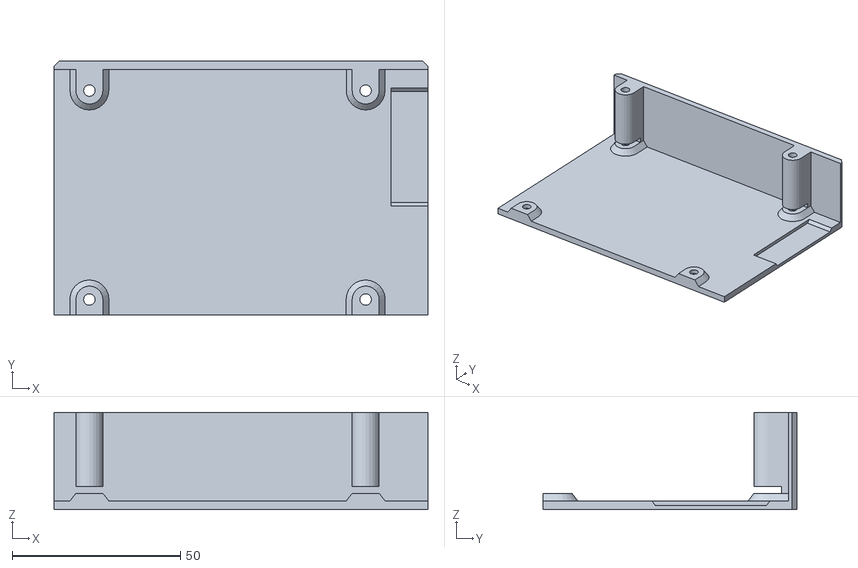
[picture p50: CAD file, 2025-06-22]
STL/MakerBase Box Cover.stl
111.0 x 75.3 x 28.8
