EdgarMata/MY-Laser-CNC/STL/Y Chain Bracket.stl

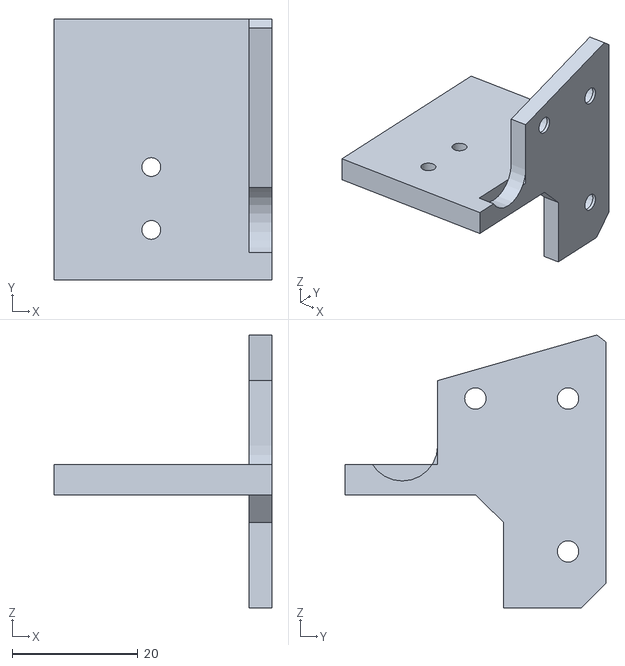
[picture p51: CAD file, 2025-06-22]
STL/Y Chain Bracket.stl
34.6 x 41.6 x 43.4
