EdgarMata/MY-Laser-CNC/STL/Laser Mount Plate.stl

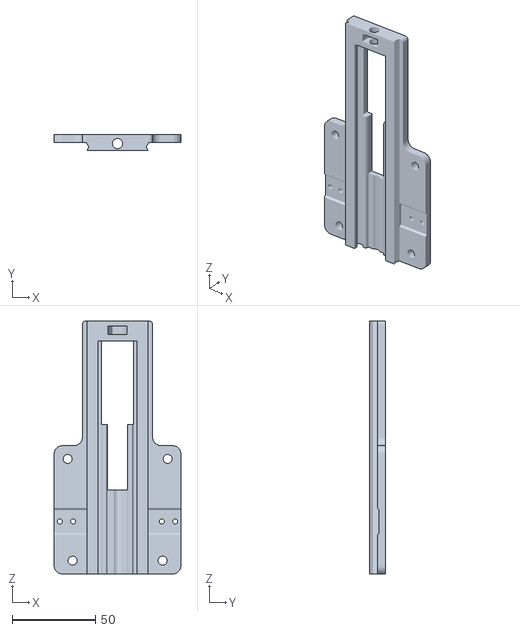
[picture p52: CAD file, 2025-06-22]
STL/Laser Mount Plate.stl
76.1 x 9.75 x 151.7
