EdgarMata/MY-Laser-CNC/STL/LCD Box.stl

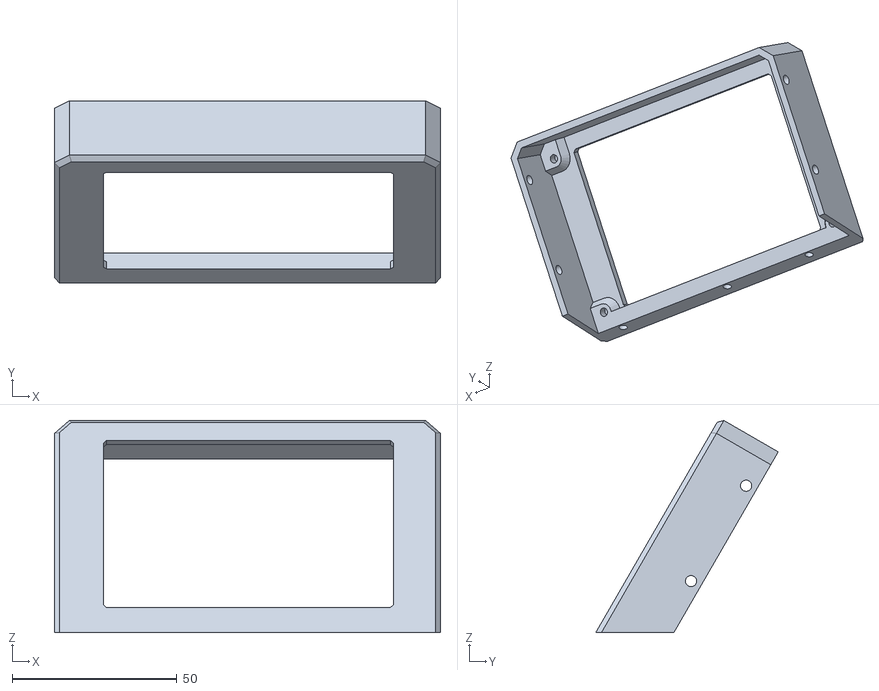
[picture p53: CAD file, 2025-06-22]
STL/LCD Box.stl
117.0 x 55.3 x 64.3
