EdgarMata/MY-Laser-CNC/STL/Knob Upper.stl

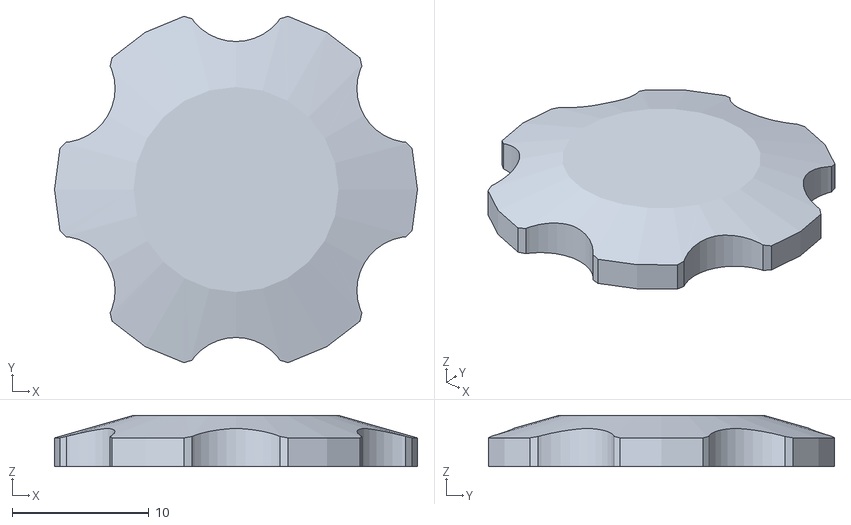
[picture p54: CAD file, 2025-06-22]
STL/Knob Upper.stl
26.5 x 25.3 x 3.75
