EdgarMata/MY-Laser-CNC/STL/Laser Mount Suport.stl

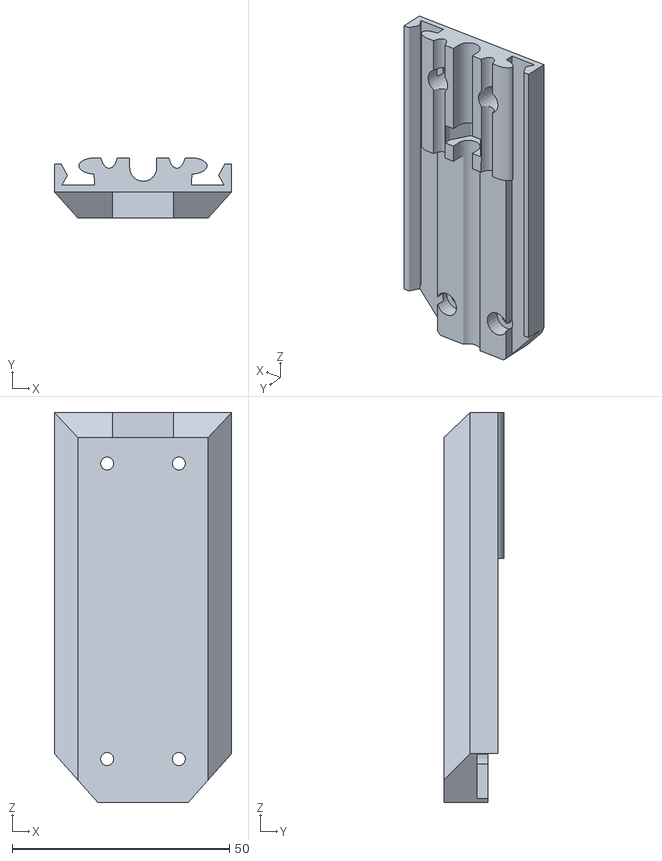
[picture p55: CAD file, 2025-06-22]
STL/Laser Mount Suport.stl
40.8 x 13.8 x 89.7
