EdgarMata/MY-Laser-CNC/(list of files, cad)

Other CAD files:
STL/Acrylic Shield.stp
Ai Assist 12V - Ortur LaserMaster 2/OLM2 V1 - Feet 3x.STL
Ai Assist 12V - Ortur LaserMaster 2/OLM2 V1 - Feet Motherboard.STL
Ai Assist 12V - Ortur LaserMaster 2/OLM2 V1 - Laser Mount Bracket.STL
Ai Assist 12V - Ortur LaserMaster 2/OLM2 V1 - Laser Mount Motor Bracket .STL
Ai Assist 12V - Ortur LaserMaster 2/OLM2 V1 - Nylon Spacer 6mm.STL
Ai Assist 12V - Ortur LaserMaster 2/OLM2 V1 - X Left Mount.stl
Ai Assist 12V - Ortur LaserMaster 2/OLM2 V1 - X Right Mount.stl
Ai Assist 12V - Ortur LaserMaster 2/OLM2 V1 - Y Limit Switch.stl
Ai Assist 12V - Ortur LaserMaster 2/files/OrturAirAssist_Part_1.stl
Ai Assist 12V - Ortur LaserMaster 2/files/OrturAirAssist_Part_2.stl
Ai Assist 12V - Ortur LaserMaster 2/files/OrturAirAssist_Part_3.stl
Ball+Bearing+5+x+16+x+5_1_0.skp
Cooler.skp
Dragchain mounts - Ortur LaserMaster 2/files/Dragchain_guide_clamp.stl
Dragchain mounts - Ortur LaserMaster 2/files/X_axis_Dragchain_Stepper_mount.stl
Dragchain mounts - Ortur LaserMaster 2/files/X_axis_Dragchain_guide_mount_-_Left.stl
Dragchain mounts - Ortur LaserMaster 2/files/X_axis_Dragchain_guide_mount_-_Right.stl
Dragchain mounts - Ortur LaserMaster 2/files/Y_axis_Dragchain_Stepper_mount.stl
Dragchain mounts - Ortur LaserMaster 2/files/Y_axis_Dragchain_guide_mount_-_Back.stl
Dragchain mounts - Ortur LaserMaster 2/files/Y_axis_Dragchain_guide_mount_-_Front.stl
Eccentric+Spacer+6mm_1_1.skp
Emergency Stop.skp
Height Adjustment - Ortur LaserMaster 2/files/ObjectFilePart1_ifYouNeed.obj
Height Adjustment - Ortur LaserMaster 2/files/ObjectFile_Part2_if_youNeed.obj
Height Adjustment - Ortur LaserMaster 2/files/Ortur_Height_Adjustment_Part_12.stl
Height Adjustment - Ortur LaserMaster 2/files/Ortur_Height_Adjustment_Part_1_NewVersion.stl
Height Adjustment - Ortur LaserMaster 2/files/Ortur_Height_Adjustment_Part_1_withExtraMoreTolerance.stl
Height Adjustment - Ortur LaserMaster 2/files/Ortur_Height_Adjustment_Part_2_NewVersion.stl
L+Bracket+Double_1_0.skp
MKS_3.5__TFT35_Screen_Case_for_Ender-3/files/Front_Cover_LS_TFT35.stl
MKS_3.5__TFT35_Screen_Case_for_Ender-3/files/Front_Cover_TFT35.stl
MKS_3.5__TFT35_Screen_Case_for_Ender-3/files/Rear_Cover_TFT35.stl
STL/Acrylic Shield.FCStd
STL/Acrylic Shield.skp
STL/Acrylic Shield.stl
STL/Black/Adaptador Venoinha.stl
STL/Black/Black - Cable Cover Left.stl
STL/Black/Black - Cable Cover Right.stl
STL/Black/Black - Cable Cover.stl
STL/Black/Black - Chain End Mount.stl
STL/Black/Black - Chain Guide bracket.stl
STL/Black/Black - Chain Guide bracket_Cable Guide.stl
STL/Black/Black - Chain Link Cover.stl
STL/Black/Black - Chain Link.stl
STL/Black/Black - Chain Start Mount.stl
STL/Black/Black - Knob Lower.stl
STL/Black/Black - Knob Upper.stl
STL/Black/Black - Knob.stl
STL/Black/Black - MKS DLC32 Box Cover.stl
STL/Black/Black - MKS DLC32 Box Housing.stl
STL/Black/Black - X Motor Cable Cover.stl
STL/Blue/Blue - Belt Holder.stl
STL/Blue/Blue - Dragchain guide mount (X).stl
STL/Blue/Blue - Dragchain guide mount (Y).stl
STL/Blue/Blue - Foot (L) V2.stl
STL/Blue/Blue - Foot (R) V2.stl
STL/Blue/Blue - LCD Box V2.stl
STL/Blue/Blue - LCD Support (L) V2.stl
STL/Blue/Blue - LCD Support (R) V2.stl
STL/Blue/Blue - Laser Mount Motor Bracket.stl
STL/Blue/Blue - Laser Mount Plate.stl
STL/Blue/Blue - Laser Mount Suport 80W.stl
STL/Blue/Blue - Laser Mount Suport.stl
STL/Blue/Blue - Laser Mount.stl
STL/Blue/Blue - Spacer.stl
STL/Blue/Blue - X Chain Bracket.stl
STL/Blue/Blue - X Gantry Inner Mount Plate (L).stl
STL/Blue/Blue - X Gantry Inner Mount Plate (R).stl
STL/Blue/Blue - X Gantry Outer Mountl Plate (L).stl
STL/Blue/Blue - X Gantry Outer Mountl Plate (R).stl
STL/Blue/Blue - Y Chain Bracket.stl
Sainsmart+CNC+Laser.skp
Solid+V+Wheel_1_0.skp
Tee+Nut_M5_1.skp
USB+Logo.skp
V-Slot+ALL+Linear+Rail_1_0.skp
