EdgarMata/MY-Laser-CNC/Height Adjustment - Ortur LaserMaster 2/files/orturModPrintManual.pdf

### Height_Adjusmentfor OrturLaserMaster20W

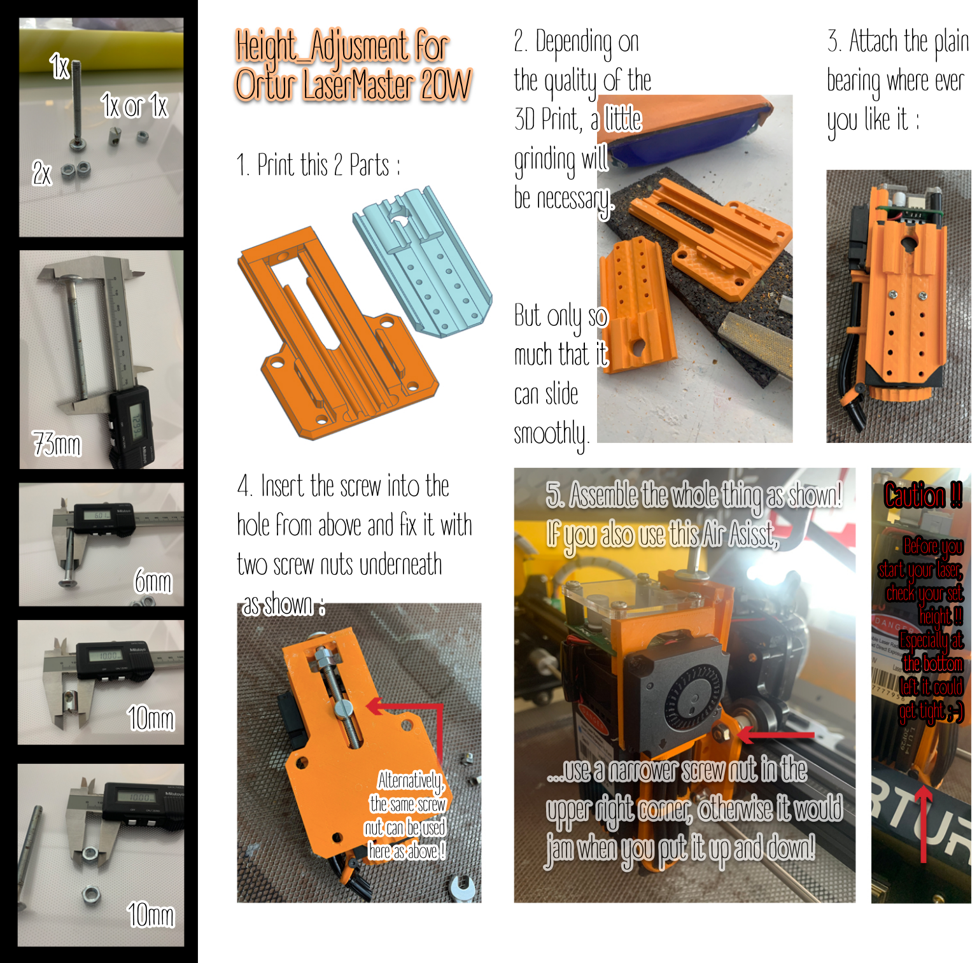
[picture p56: page 1]

1.Printthis2Parts:

2.Dependingon
thequalityofthe
3DPrint,alile
grindingwi
beneceary.

Butonlyso
muchthatit
canslide
smoothly.

1x
1xor1x
2x

3.Aachtheplain
bearingwhereever
youlikeit:

4.Insertthescrewintothe
holefromaboveandfixitwith
twoscrewnutsunderneath
asshown:

Alternatively,
thesamescrew
nutcanbeused
hereasabove!

5.Aemblethewholethingasshown! IfyoualsousethisAirAsit,

...useanarrowerscrewnutinthe upperrightcorner,otherwiseitwould jamwhenyouputitupanddown!

73

6

10

10

Caution!!

Beforeyou
startyourlaser,
checkyourset
height!!
Especiayat
theboom
leftitcould
gettight;-)
