EdgarMata/MY-Laser-CNC/Makerbase-MKS-DLC-GRBL-OFFLINE-Laser-CNC-Control-Board-TFT35-TFT24-Touch-Screen-Replace-Shield-v3.jpg

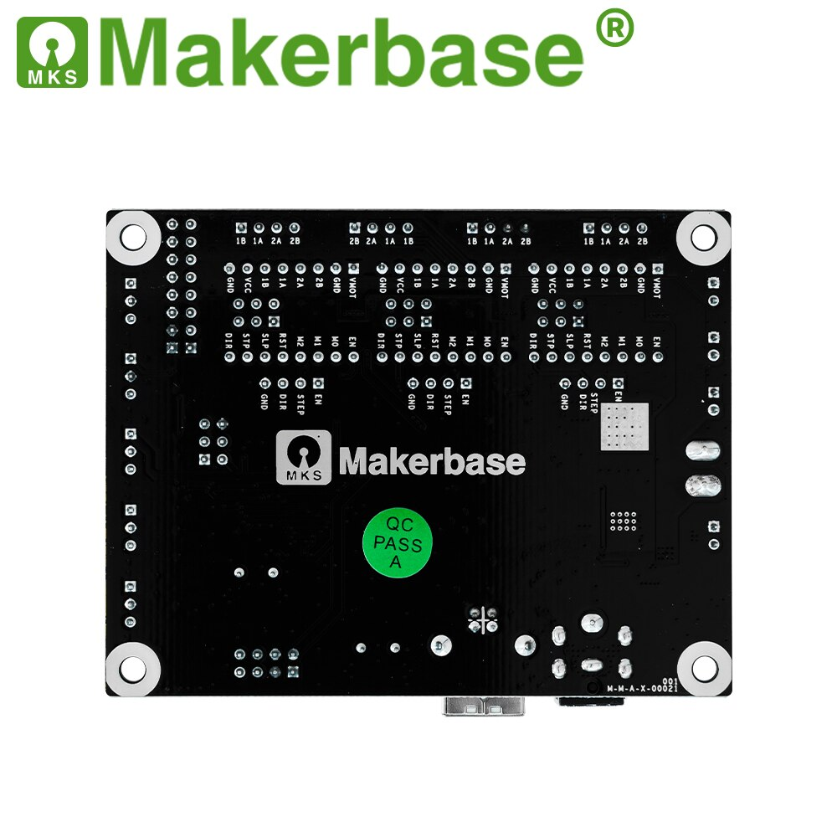
Makerbase-MKS-DLC-GRBL-OFFLINE-Laser-CNC-Control-Board-TFT35-TFT24-Touch-Screen-Replace-Shield-v3.jpg
