EdgarMata/MY-Laser-CNC/(commit log)

2024-07-02 $inicial commit
    [Acrylic Shield.FCStd, Acrylic Shield.skp, Acrylic Shield.stl, Acrylic Shield.stp, Adaptador Venoinha.stl, Ball+Bearing+5+x+16+x+5_1_0.skp, Base Bracket.stl, Belt Holder.stl]
2025-02-26 update 25-02-2025
    [BOM - 2025-01-04.csv]
2025-06-22 Reset total do repositório
    [Acrylic Shield.FCStd, Acrylic Shield.skp, Acrylic Shield.stl, Acrylic Shield.stp, Adaptador Venoinha.stl, BOM - 2025-01-04.csv, Ball+Bearing+5+x+16+x+5_1_0.skp, Base Bracket.stl]
